SomeZeldaFan/RocketPi-5/docs/01-constraints.md

# Project Constraints & Context

**Version:** v1.1 (locked — supersedes v1.0)
**Last updated:** 2026-05-21
**Status:** Phase 0 complete. Phase 1 complete — architecture locked (D024–D034), hardware selected (D038–D042), coding framework complete (D043). Validation protocol locked (D045, §10.7).

---

## 1. Mission Need

Design, build, and validate a bench-top model rocketry GNC (Guidance, Navigation, and Control) suite demonstrating closed-loop attitude control with fault-tolerant sensor fusion under deliberate sensor compromise — using a Raspberry Pi 5 as the development and ground station platform.

This is a *founding statement*, not a specification. Specifications are downstream.

---

## 2. Intended Audiences

- **Aerospace engineering faculty** — the primary technical audience. The project engages real aerospace subdisciplines (GNC, FDIR) and must hold up to domain scrutiny.
- **Current program professor** — issued the Pi 5 kit; expects a completed deliverable. Scope and documentation must be legible to a software engineering background.
- **UAE aerospace and defense industry** — secondary audience for whom fault-tolerant GNC and GPS-denied operation analogues are directly relevant.
- **The builder** — technical growth and genuine understanding are first-class outcomes, not side effects.

---

## 3. Resources

### 3.1 Hardware on hand

Raspberry Pi 5 kit: Pi 5, breadboard, LCD display, starter kit components, power supply, SD card, case.

### 3.2 Tools available

- Soldering iron (trivial to acquire).
- Multimeter (trivial to acquire).
- 3D printer (accessible via family).
- Development computer: Ryzen 7 9700X, RTX 4080 Super, 64 GB DDR5. Firmware development, post-test analysis, and ML workloads are first-class options.

### 3.3 Acquirable

Additional sensors, microcontrollers, flight controllers, RF modules, mounting structures, 3D-printed parts, etc., all in scope subject to budget.

### 3.4 Budget

Soft ceiling **~$2,000 USD** across the project lifetime (excluding tools listed in 3.2). Not a hard cap; specific expenditures justified case-by-case.

---

## 4. Project Shape

**Bench-only model rocketry GNC suite, avionics- and systems-centric.**

The system is built to operational completeness on a test stand — IMU, sensor fusion, state estimation, control law, servo-driven aerodynamic control surfaces, ground station — but is **not flown**. Flight is excluded for procurement, regulatory, and logistical reasons (see §5).

The airframe is a custom-designed, 3D-printed semi-monocoque structure — a parallel structural engineering chapter of the project, not packaging. No resin, fibreglass, chemical coatings, or fibrous reinforcement of any kind. Structural reinforcement strategy (including possible metal linkages) is open. (D031, retires D011; D044 opens reinforcement boundary.)

The Pi 5 is bounded to: telemetry reception, frame logging, dashboard UI, and C2 command transmission. It is not in the real-time control path. (D032.)

A dedicated STM32F407ZGT6 MCU owns the entire real-time path: sensor read, sensor fusion, FDIR, control law, actuator command, mode FSM, and time authority. (D039, D025.)

---

## 5. Depth Axis: Fault-Tolerant Graceful Degradation

Beyond nominal closed-loop control, the system demonstrates **robust operation under deliberate sensor compromise.**

Failure modes characterized in scope:

- Magnetometer disturbance (nearby metal, magnetic interference)
- IMU sensor degradation or loss
- Sensor disagreement (innovation gating)
- Sensor disconnection

The system detects sensor inconsistency, isolates the faulty channel, and continues operating with degraded but bounded accuracy. This is the project's *distinctive depth axis* and what separates it from "student built a control system."

Robustness is **architected from day one**, not retrofitted (see §10).

This direction is selected because:

- It is honest to the bench setup (sensor robustness exists for stationary and moving vehicles alike).
- It maps to a real aerospace subdiscipline (FDIR — Fault Detection, Isolation, and Recovery).
- It is genuinely defense-relevant (jamming, spoofing, adversarial sensor environments).
- It does not force a project-identity reframe.

---

## 6. Demos (Deliverables)

### Demo 1 — Live bench demo (PRIMARY)

Live demonstration of control surfaces responding to physical perturbation of the test stand. Includes nominal operation and live demonstration of fault tolerance: disconnect a sensor mid-operation, watch the estimator degrade gracefully and report sensor health.

---

## 7. Scope: Inclusions

- IMU-based attitude estimation (sensor fusion, state estimator)
- Closed-loop control law driving servo-actuated aerodynamic control surfaces
- Sensor health monitoring and fault detection logic
- Graceful degradation under sensor compromise
- Bidirectional telemetry link between MCU and Pi 5 ground station. Downlink: sensor data, estimator state, sensor health. Uplink: mode commands from ground station to MCU.
- **Demo/flight mode toggle** — ground station can command the MCU between flight mode (real deflection limits) and demo mode (relaxed deflection limits for presentation legibility). MCU acknowledges all mode commands; ground station reflects active mode and acknowledgment status.
- **Live ground station UI** running on the Pi 5 (1024×600 touch display, or external monitor). Multi-pane dashboard showing: live telemetry charts, sensor health status and confidence indicators, the system's own estimate of data accuracy and veracity, a real-time 3D attitude visualization of the rocket body driven by the estimator output, and a separate zoomed view of the fin assembly showing actuated control surface deflections as they occur.
- Post-test analysis tooling (Python, on dev machine)
- Documentation: requirements, architecture, decisions, test results, post-project writeup

## 8. Scope: Exclusions

- **No flight.** Static / bench testing only.
- **No propulsion work.** Commercial motors only (and only as static prop, not fired).
- **No TVC (thrust vectoring control)** on any flight-intended article.
- **No projectiles, no kinetic payload, no weaponization** of any kind, in any framing.
- **No live motor firing.** Static fire tests are out of scope.
- **No multi-stage anything.** Single article, single configuration.
- **No GCAA permission-seeking** for this project. Closed; will not be revisited.
- **No swarm, no multi-vehicle.** Single article.
- **No autonomous mission planning.** This is a control system project, not an autonomy project.

---

## 9. Engineering Quality Rubric

Candidate scope additions and design decisions are evaluated against the following criteria. Re-read before any meaningful scope decision.

1. **Domain authenticity** — engages a real aerospace problem, not cosmetically. Fault-tolerant estimation is the project's primary authenticity claim.
2. **Technical depth** — at least one component requiring genuine learning beyond tutorial-level. The sensor fusion + fault detection pipeline carries this.
3. **Systems integration** — multiple subsystems with real interfaces. IMU, MCU, servos, telemetry radio, ground station — all must compose.
4. **Documentation & rigor** — written up as if for review. Requirements traced, decisions justified, results measured.
5. **Demonstrability** — non-builder can appreciate the result in under five minutes (Demo 1 satisfies this).
6. **Originality of choice, not invention** — the specific framing (bench-only, fault-tolerant, GNC-focused, defense-adjacent) is uncommon. Not novel research; genuinely uncommon at student level.
7. **Slog-to-learning ratio** — concepts and tasks should be net learning-dense. Mechanical tedium is acceptable when budgeted; uncharacterized tedium is a planning failure.

---

## 10. Locked Principles

### 10.1 Slog is estimated explicitly

Every concept and major task is evaluated for the ratio of learning-dense work to mechanical-tedium work. Slog phases are planned for, not encountered. We do not psych ourselves up about tedium; we put it in the schedule. (Adapted from how mature engineering organizations plan integration and test campaigns — slog is called schedule margin in industry.)

### 10.2 Architect for robustness from day one

Fault tolerance is not Phase 2. It shapes the architecture from the first commit. The first version of any estimator may be a trivial nominal implementation, but it exposes the *interfaces* fault tolerance needs: sensor health channels, innovation tracking, confidence bounds, graceful degradation paths. Retrofitting robustness is 2–3× the cost of designing for it. We will not pay that cost.

### 10.3 Decisions go in the log

Every architectural or scope decision is logged with date, decision, alternatives considered, and rationale. We do not relitigate decisions; we read the log.

### 10.4 Procurement reality is a hard constraint

The trade space is bounded by what can actually be acquired in the UAE within budget. Theoretical availability is not availability.

### 10.5 Authoritative sources for regulatory questions

When regulatory questions arise, the regulator (or its published rules) is the source of truth — not inference, not e-commerce restrictions, not forum posts. (Pattern established when contacting GCAA early in Phase 0.)

### 10.6 JPL Power of 10 coding standard

All control-path and flight-critical code abides by the NASA JPL Power of 10 rules. This is a non-negotiable quality floor, not a stretch goal.

### 10.7 Validation before implementation — tests are written before code

No code is flashed to hardware until it has passed its full dev-PC validation suite. No subsystem integration begins until per-peripheral bring-up tests pass. Tests are written before the module they test is implemented — a test written after the code confirms the code as written; a test written against the contract verifies the contract. Progression follows a non-bypassable gate structure (see `docs/07-test-plan.md`); a test that has not been run counts as a failing test. (D045.)

---

## 11. Open Questions

1. **True C2 depth (stretch).** Full command and control implementation — command authentication, sequencing, and link-loss fail-safe behavior on the MCU — is a stretch goal. Scope if time permits after core control loop is validated.

---

## 12. Version History

- **v0.1** (2026-05-11): Initial strawman. No domain locked.
- **v0.2** (2026-05-11): Domain locked (model rocketry). Project shape locked (bench-only, GNC-focused, avionics-centric). Depth axis locked (fault-tolerant graceful degradation). Flight excluded. Demos redefined. Scope inclusions and exclusions enumerated. Locked principles enumerated. Open questions surfaced.
- **v0.3** (2026-05-12): Public-facing reframe — mission statement depersonalized, stakeholder framing neutralized (§2 renamed to Intended Audiences), §9 renamed to Engineering Quality Rubric, JPL Power of 10 added as §10.6.
- **v0.4** (2026-05-12): Scope update — SD card onboard logging removed (Pi 5 handles all logging over telemetry); ground station UI description expanded to reflect multi-pane dashboard with 3D attitude visualization and fin deflection view.
- **v0.5** (2026-05-12): Open questions reframed as timeless (removed phase-gate language); NASA-STD-7009 added as a deferred candidate for simulation validation.
- **v0.6** (2026-05-12): Telemetry link made bidirectional; demo/flight mode toggle added to scope (D020); true C2 depth added as stretch open question.
- **v0.7** (2026-05-12): Time constraints removed from all sections; D002 retired via D021.
- **v0.8** (2026-05-15): Phase 1 top-level architecture review locked (D024–D034). Custom semi-monocoque 3D-printed airframe path adopted (D031); D011 retired. §8 airframe exclusion removed. §11.4 airframe-presence open question resolved. §11.1 (MCU choice) and §11.2 (IMU/baro selection) annotated with bounded trade spaces from the architecture decisions; open-question numbering shifted accordingly.
- **v0.9** (2026-05-19): Document prose cleaned up. Renumbered §3 subsections and remaining open questions.
- **v1.0** (2026-05-21): §4 updated to reflect Phase 1 locked decisions — custom semi-monocoque airframe (D031), Pi 5 role (D032), MCU selection (D039). D044 opens airframe reinforcement boundary.
- **v1.1** (2026-05-21): §10.7 added — validation-before-implementation locked principle (D045).
