SomeZeldaFan/RocketPi-5/docs/02-current-state.md

# Current State

**Last updated:** 2026-06-17

Live project status. Updated at the end of every work session.

---

## Where we are

**Phase:** Phase 1 — requirements first pass complete (D035–D036 logged). Hardware selection complete (D038–D042). Coding framework scaffold complete (D043, 2026-05-20): software architecture §4 locked, avionics directory layered scaffold created, all module headers + stub `.c` files in place. Test plan fully populated (2026-05-21): `docs/07-test-plan.md` carries the complete test enumeration and the G0–G4 gate structure; validation-before-implementation locked as a principle (D045, §10.7). **`platform.h` scrutiny complete (2026-06-17)** — the first per-module header scrutiny session: D048 (NVIC priority scheme) and D053 (watchdog architecture) logged, `platform.h` contract locked, foundation header `inc/fault.h` added. Active tracks: per-module header scrutiny continues (sensor-driver headers next), airframe structural design (CAD), literature reviews LR-2/LR-3 (unblocked by hardware selection; LR-1 complete per D052). Servos deferred pending CAD. **Host build+test loop established (2026-06-17)** — the algorithm layer + test harnesses compile and run natively on macOS/Apple Silicon via `avionics/Makefile`; all software development and testing now happens on the Mac (dev-PC dependency removed).

**Constraints doc:** v1.1 locked.
**Domain:** Locked — bench-only model rocketry GNC suite.
**Depth axis:** Locked — fault-tolerant graceful degradation under sensor compromise.
**Flight:** Excluded.
**System architecture:** Locked (D024–D034). Custom semi-monocoque airframe path adopted (D031); D011 retired.
**Software architecture:** Locked (D043). Bare-metal superloop with DMA + ISRs. Layered scaffold (hardware / algorithm / output / orchestration) in `avionics/` — see `docs/05-architecture.md §4`.

Pi 5 bring-up complete (DietPi v10.3.3, kernel 6.18.29, SSH access confirmed, GPIO stack verified). VS Code Remote-SSH setup deferred. Avionics component selection complete (D038–D042). Coding framework scaffold complete (2026-05-20) — MCU is STM32F407ZGT6; toolchain is STM32CubeIDE + HAL.

---

## What's done

- Phase 0 complete — project shape, depth axis, scope, and principles all locked.
- Constraints document locked at v1.1 (v1.0: §4 updated for Phase 1 decisions; v1.1: §10.7 validation-before-implementation principle added).
- Decisions log populated: D001–D052 (D048 reserved — NVIC priority scheme, to be logged in the `platform.h` scrutiny session; D050 logged 2026-06-14 — FDIR/estimator boundary).
- Coding standard locked: NASA JPL Power of 10.
- **Test plan fully populated (2026-05-21)** — `docs/07-test-plan.md` carries the complete test enumeration (build artifact, platform, all five sensor/peripheral bring-ups, FDIR/estimator/control-law/telemetry/C2/FSM unit tests, code coverage, boundary cases, exhaustive FSM coverage, power, bus contention, per-peripheral and concurrent fault injection, pipeline integrity, fault propagation, reboot recovery, timing margin, watchdog recovery, soak) and the non-bypassable G0–G4 gate structure. Tests are written before the modules they test (D045).
- **D044–D049 logged.** D044: airframe reinforcement boundary revised. D045: test protocol and gate structure. D046: actuator fault detection — operator-asserted (no servo feedback path). D047: loop overrun policy — warn, halt on 3 consecutive. D049: FSM responds to sensing health only, not actuator health.
- Ground station scope defined: multi-pane dashboard, 3D attitude visualization, fin deflection view, bidirectional C2 link, demo/flight mode toggle.
- **Phase 1 architecture review complete** (per D023). Eleven structural decisions logged as D024–D034, covering: IMU configuration, real-time path ownership, sensor bus topology, barometer inclusion, telemetry radio termination, MCU↔Pi physical link, control surface count, test stand / airframe configuration, Pi 5 role precision, power architecture, and authoritative time source.
- **Hardware selection complete** (D038–D042). UAE 433 MHz band confirmed (TDRA). MCU: STM32F407ZGT6 core board. IMU-1: GY-BMI160 (Bosch BMI160). IMU-2: ICM-42688-P breakout (TDK InvenSense). Barometer: MS5611 via GY-63 module. Radio: HolyBro SiK V3 433 MHz pair. All components on breakout modules or core boards — no custom PCB required. ST-Link V2 and full tooling procured. LR-2, LR-3, and coding framework all unblocked.
- Architecture document populated with hardware architecture (§2) and airframe structural architecture (§3 skeleton).
- Risk register, test plan, and bibliography expanded with airframe-side entries.
- **Pi 5 bring-up complete.** DietPi v10.3.3 installed on kernel 6.18.29+rpt-rpi-2712. SSH access confirmed at 192.168.3.25 (wlan0). GPIO stack verified: lgpio 0.2.2 + gpiozero 2.0.1 on gpiochip0 (RP1). Hardware revision e04171.
- **Requirements document first pass complete** (docs/04-requirements.md). Sections 1–8 populated: system-level, estimation, control, FDIR, telemetry, ground station, power, documentation. Sections 9–10 (airframe, demonstration) deferred as stubs. Eight performance requirements carry [TBD] placeholders pending literature review (LR-1 through LR-3) — see in-progress below.
- **D043 logged (2026-05-20)** — scheduling model: bare-metal superloop with DMA + ISRs. FreeRTOS explicitly rejected. Five-reason rationale documented; alternatives considered.
- **Software architecture §4 written and locked (2026-05-20)** — `docs/05-architecture.md §4`. Module decomposition, scheduling model with 12-step tick sequence, ISR table with volatile discipline, canonical type definitions, fault propagation chain with four invariants, module interface contracts, test harness strategy. GCS architecture explicitly deferred to its own session.
- **Avionics scaffold complete (2026-05-20)** — layered directory structure (`hardware/`, `algorithm/`, `output/`, `orchestration/`). `avionics_types.h` (canonical types, `volatile_flag_t`, `AVIONICS_PROTOCOL_VERSION`), `isr_flags.h` (manifest of all ISR/main-loop boundary crossings), 12 module headers with real declarations + comment contracts, 12 stub `.c` files with PLACEHOLDER RETURN comments and zero functional code, `main.c` superloop skeleton expressing the 12-step tick sequence, `stm32f4xx_it.c` and `stm32f4xx_hal_msp.c` HAL stub files, 4 dev-PC test harness stubs.
- **LR-1 complete (2026-05-22, D052)** — `AVIONICS_LOOP_RATE_HZ` = 1000 Hz locked; `IMU_STALENESS_THRESHOLD_US` = 5000 μs. Derived from 10 Hz disturbance bandwidth × 5× margin × Franklin Eq. (11.3) sampling rule. REQ-SYS-011, REQ-EST-002, REQ-CTL-008 resolved. LR-3 unblocked. Full write-up: `docs/derivations/LR-1-loop-rate.md`.
- **FDIR/estimator boundary resolved (2026-06-14, D050)** — two-phase estimator (`estimator_predict`/`estimator_update`) + two-phase FDIR (`fdir_admit`/`fdir_gate`), interleaved admit→predict→gate→update; new `predicted_readings_t` carries the estimator's predicted measurements to the gate as data (no estimator import). FDIR writes health in two passes (admit preliminary, gate restrict-only). Architecture §4.1/§4.2/§4.4/§4.5 updated and signatures locked. Unblocks the EKF and FDIR innovation-gate implementations and TEST-EST-011.
- **`platform.h` scrutiny complete (2026-06-17) — D048 + D053 logged.** First per-module header scrutiny session. **D048** (NVIC priority scheme): `NVIC_PRIORITYGROUP_4`, TIM2=0 / DMA-TC=1 / SysTick=15; boundary-variable consistency is structural (single word-aligned access + single-writer-per-variable), priority is latency/jitter only; the one main-loop RMW (flag-clear + page-index snapshot) is guarded by a `BASEPRI` critical section; the IMU double-buffer page index is now declared in `isr_flags.h`. **D053** (watchdog architecture): IWDG-only, prescaler /32 RLR 2937 (2.00/2.94/5.53 s band, fast corner anchored at 2.0 s), single-window boot with no per-`_init()` kicks, a boot-complete kick + tick-[13] kick loop, ordered RCC_CSR reset-cause readout (new `reset_cause_t` + `platform_reset_cause()`), accepted high-Z reset window with software safe-state, and a central `system_safe_halt()` (new foundation header `inc/fault.h`, defined in `orchestration/fault.c`) replacing the removed `platform_safe_state()`. `void` fail-fast init convention locked. TEST-PLT-005 and TEST-PLT-HW-007 unblocked; TEST-PLT-002 / PLT-HW-003/004/005 / WDG-001/002/003 updated. `platform.h` is implementation-ready.
- **Host build+test loop complete (2026-06-17).** `avionics/Makefile` builds the platform-independent algorithm layer (`estimator.c` / `fdir.c` / `control_law.c`) + the four test harnesses with Apple clang under the strict JPL flag set (`-std=c11 -Werror -pedantic -Wconversion -Wsign-conversion -Wcast-qual …`), running natively as arm64 on the MacBook Air M3; `make test` reports red/green. `avionics/test/test_support.c` supplies a host `system_safe_halt` (print + `abort()`) and an `assert_fail` location-capture; `inc/fault.h` gains a `-DHOST_TEST` ASSERT branch (D053-A7 amendment) that leaves the target ASSERT expansion provably unchanged. All software dev/test now runs on the Mac — no dev-PC dependency. The shared CHECK/report harness header is deferred to the first real test.
- **Magnetometer selected — D054 logged (2026-06-17).** Bosch **BMM150** on a **dedicated I2C bus** (alone on its own peripheral, not the MS5611 bus — preserves D026 isolation; a mag-bus hang cannot take the barometer). Yaw is now an observable, bounded EKF state; the constraints §5 magnetic-disturbance failure mode is now achievable. Canonical types gained `mag_status_t`, `mag_reading_t`, and `mag_healthy` in `health_flags_t`; `AVIONICS_PROTOCOL_VERSION` bumped 1 → 2 (wire-layout change). Header compiles clean under the strict host flags and all four host test executables still pass — no contract regression. No driver yet (hardware-layer mag driver is task 7). **R-YAW-01 closed.** Procurement caveat carried: the module must be a standalone BMM150, not a BMX160. Provisional `R` for the mag update awaits LR-2.
- **Estimator/FDIR contract made mag-ready — D060 + D061 logged (2026-06-18).** **D060** amends the D050-locked algorithm contract so the magnetometer flows through the pipeline: `predicted_readings_t` gains `mag_pred_ut[3]`; `fdir_gate_result_t` gains `chi2_mag` / `mag_gate_open` / `mag_stale_us`; `estimator_update`, `fdir_admit`, `fdir_gate` each gain a `const mag_reading_t *mag` param; architecture §4 + `main.c` call sites updated. The `.c` bodies stay stubs (real logic is Task 2 / Task 3). Honest framing recorded: the lone mag has no twin → no direct cross-check; it is gated analytically (innovation vs the IMU-predicted field) plus absolute invariants (`|B|` magnitude, dip angle) — which is what makes the §5 mag-disturbance mode detectable with one sensor. Host build clean + all four test exes pass (no contract regression). **D061** records the estimator state design for Task 2: true dual-IMU fusion via a 9-state error EKF with **per-IMU gyro bias** `[δθ, δb₁, δb₂]` (internal to `estimator.c`; no public-type change). This **unblocks Task 2 implementation.**
- **Estimator design locked + contract finalized — D062 logged (2026-06-18).** Full `estimator.c` design recorded so the coding session is pure algorithm: error-state MEKF (9-state), small-angle quaternion propagation, **sequential-scalar + Joseph-form** updates (accel₁/accel₂/mag + a **differential-bias pseudo-measurement** `H=[0|I|−I]`), single-precision numerical hygiene (renorm/symmetrize/PD-floor), Hamilton/NED conventions, accel+mag init, freeze-isolated-bias degraded modes, provisional `R`/`Q`/`P`/`g_nav`/`B_nav` with must-replace markers, JPL fixed-size purpose-built primitives, and **simple-robust-auditable-first** (compute is single-digit-% on the M4F — not the binding constraint). Two contract tweaks applied this session: **baro removed from `estimator_update`** (altitude unobservable in attitude-only state; FDIR still monitors baro), and **`attitude_estimate_t.covariance[6]→[9]`** (full EKF error diagonal) → **`AVIONICS_PROTOCOL_VERSION` 2→3** (GCS/telemetry must match). **Implementation method:** code landed section-by-section (≤50-line reviewed sections, deferred-commit-until-done).
- **TASK 2 COMPLETE — `estimator.c` implemented + validated (2026-06-19, D062).** The full 9-state error-state EKF is built and tested: nominal quaternion + per-IMU gyro bias; predict (gyro blend → small-angle propagation → `F·P·Fᵀ+Q` → predicted accel/mag for the gate); update (sequential-scalar Joseph corrections: accel₁/accel₂ → roll-pitch, mag → yaw, differential-bias → per-IMU separability); degraded modes via the NULL contract (IMU1/IMU2-only, dead-reckoning, freeze-isolated-bias); single-precision hygiene (renorm/symmetrize/PD-floor). JPL-clean: fixed-size, no malloc/recursion, bounded loops, single-precision `float`, ≥2 ASSERT/fn. **Validation:** `test_estimator.c` — 3045 checks across 12 scenarios, all green (static convergence; all three Euler signs incl. a DCM-independent analytic case; rotation tracking; degraded modes; covariance grows-on-loss/never-zero; reset/replay exact determinism; the **200× yaw-bounded-with-mag-vs-drifts-without** demo; per-IMU bias observability; noise robustness ~0.1°). `make coverage` (new target, shared `check.h` harness): **estimator.c 100% line, 100% function, 99.32% branch** (the one residual is the defensive PD-floor guard; assertion-failure arms excluded — death-tests deferred D053-A7). All provisional `R`/`Q`/`P`/`g_nav`/`B_nav` carry must-replace-before-ship markers (LR-2 / geomagnetic model). Critical path **1→2 done**; Task 3 (FDIR) is next.
- **TASK 3 COMPLETE — `fdir.c` implemented + validated; telemetry contract cleaned (2026-06-19, D063).** Two-pass FDIR built to the D050/D060 contract with a **two-tier severity model**: `fdir_admit` runs TIER-1 (hard) absolute checks (status, staleness, physical envelope/saturation, NaN/Inf, mag `|B|`) → **immediate latch**; `fdir_gate` runs TIER-2 (soft) innovation checks (per-channel chi² + the mag dip-angle) → **debounced latch** after `FDIR_DEGRADE_COUNT` consecutive failures. Per channel `health = (NOT latched) AND (no TIER-1 now) AND (gate open now)`; **latch clears only via `fdir_init()`** (reset = operator re-admit — no auto-recovery). The IMU1-vs-IMU2 gyro cross-check is a **detector only** (A1: never isolates on two-sensor disagreement; raises `gyro_disagree`). The gate normalises with **β innovation variances** exported by `estimator_predict` (`S_k = HₖP⁻Hₖᵀ+R` in `predicted_readings_t`) → adaptive, inversion-free `chi2 = Σ rₖ²/Sₖ` (no estimator import, single-precision FPU). Staleness "now" = newest input timestamp (no clock param / layer rule). JPL-clean: fixed-size static state (per-channel latch+counter), no malloc/recursion, bounded loops, ≥2 ASSERT/fn. **Telemetry-contract cleanup:** `fdir_gate_result_t` gains `gyro_disagree`; `telemetry_frame_t` gains `fdir_gate_result_t gate` + `reset_cause_t reset_cause` (D053 A4/A6) and `telemetry_pack_and_send`/`main.c` are threaded → **`AVIONICS_PROTOCOL_VERSION` bumped 3 → 4** (GCS parser + telemetry serializer must match). **Validation:** `test_fdir.c` — 83 checks across 21 functions (FDR-001…019 incl. reframed 011 + new 017/018/019, BND-001/002, the §5 mag-disturbance demo, severity/latch, restrict-only, gyro-detector, NULL-safety; TEST-FDR-014 grep confirms FDIR is the sole writer of `health_flags_t`). `make coverage` (extended to both modules): **`fdir.c` 100% line / function / branch**; `estimator.c` 99.36% branch after the β export. All provisional thresholds carry must-replace markers (LR-2 / LR-3 / CAL). Critical path **1→2→3 done**; Task 4 (control law) is next.

## What's in progress

- **Literature reviews LR-2 and LR-3.** LR-2: MEMS IMU estimation accuracy — run against BMI160 and ICM-42688-P datasheets (noise density, Allan deviation, bias instability); produces steady-state EKF error bound in degrees. Unblocked by D040. LR-3: FDIR innovation gating — chi-squared threshold and detection latency. Unblocked by D040 + LR-1 (D052, 1000 Hz).
- **Per-module header scrutiny sessions.** With the scaffold in place, each module header gets its own dedicated session to scrutinise the interface contract, type-check signatures against the fault propagation invariants, and lock the safe default returns currently marked as PLACEHOLDER. Headers do not move from scaffold to implementation-ready until they pass their scrutiny session. **`platform.h` done (2026-06-17, D048 + D053).** Next: the sensor-driver tier (`bmi160.h` / `icm42688p.h` → `ms5611.h` → `sik_radio.h`), then output (`actuators.h` / `telemetry.h` / `c2.h`), `mode_fsm.h`, `control_law.h`, and the algorithm layer (`fdir.h` / `estimator.h`) last.
- **Airframe: structural design — joint/segmentation/control-surface architecture LOCKED (2026-06-17, D055–D057).** The comprehensive head-to-tail airframe reference now exists: `docs/cad/airframe-architecture.md` (geometry, section-joint standard, datum hierarchy, stepped heat-set-insert depth solution, stringer strategy, avionics capsule, control surfaces, power/cabling, fabrication, open items). **D055** — segmentation + internal twin-flange joint (280 mm sections, OD174/bore150/12 mm wall, 8× M3 heat-set clamp ring, 4× inserted-aluminium stringer bridges with 1 mm relief, fastener-free skin; flange/stringer/bolt = axial/radial/clamp datums; no centring spigot). **D056** — control surfaces re-architected to 4 static aft fins + 4 actuated canards (canards are the sole control authority); supersedes D030's actuated-surface choice (fault-tolerance rationale preserved); requirements re-pointed (REQ-SYS-005, new REQ-SYS-013, REQ-CTL-002/003/004/005/006, REQ-FDR-001/007/009, REQ-PWR-004, REQ-GCS-005). **D057** — avionics-bay-as-detachable-capsule + dedicated 5 V servo rail (Rail B per D033). Section + joint geometry is printable now. **Remaining (CAD/open, airframe doc §12):** canard body station + pivot/linkage, static-fin attachment, nose-cone & service-panel retention (fastener-free), capsule fastening, cable mating, total length/section count, M3-vs-M4, insert model. Recommended next physical step: print a single-joint **test coupon** to validate insert depth, clamp, and skin denting before committing a full 280 mm section. **Revised same day (D058, D059):** aluminium stringers **removed** — the 8-bolt flange carries bench loads with several-times margin and a 162 mm/6 mm-wall tube is hugely over-stiff; skin wall thinned **12 → 6 mm** with bore 150 preserved (OD 174 → **162**), cutting wall volume well over half (R-AF-01 closed, R-AF-03 downgraded); the centring spigot is an **exploratory TODO**, not adopted. First article is a **minimal stack** (avionics / one empty section / aft-most / cosmetic motor mount), extend with empty sections later. D059: canards have **no aerodynamic authority** on the static bench — the demo is **commanded-response** with exaggerated demo-mode deflection for visual effect; REQ-CTL-001/006 reworded to govern the command path, not physical attitude restoration.
- **Pi 5 bring-up: VS Code Remote-SSH.** Final bring-up item — connect VS Code on dev laptop to Pi via Remote-SSH extension. Deferred from 2026-05-16 session.

### Literature review tasks — required before TBD requirements can be committed

These tasks must be completed before the indicated requirements in docs/04-requirements.md can have their numerical values set. Each produces a written summary and a justified number recommendation. **Sequencing matters — see dependency notes.**

- **LR-1 — Control loop rate** — **COMPLETE (2026-05-22, D052).** Result: 1000 Hz. See `docs/derivations/LR-1-loop-rate.md`.

- **LR-2 — MEMS IMU estimation accuracy** *(unblocks REQ-EST-006, REQ-CTL-007)*
  **Requires IMU selection first.** Runs on real datasheet noise specs (noise density, Allan deviation, bias instability) for the selected chips — not class-level estimates. Determine what steady-state attitude accuracy is achievable with the chosen dual-IMU EKF configuration. Produce a justified RMS error bound in degrees.

- **LR-3 — FDIR innovation gating design** *(unblocks REQ-FDR-008)*
  **Unblocked — LR-1 complete (D052, 1000 Hz) and IMUs selected (D040).** Chi-squared consistency test design for dual-IMU cross-check. Window size and threshold selection — uses the loop rate (1000 Hz) and IMU noise specs (datasheets) as inputs. Characterise the tradeoff between false-positive rate and detection latency. Produce a justified detection latency bound in milliseconds.

### Deferred — must be tracked, not lost

These items were explicitly deferred during the 2026-05-20 coding framework session. Each has a flagged comment in the relevant source file so the issue is not lost during downstream implementation.

- **Watchdog architecture scrutiny — RESOLVED (2026-06-17, D053).** IWDG-only (A1); /32 RLR 2937, 2.00–5.53 s band, fast corner anchored at 2.0 s (A2); single-window boot, no per-`_init()` kicks, boot-complete + tick-[13] kicks (A3); ordered reset-cause readout (A4); persistence needs no backup domain (A5); accepted high-Z window + software safe-state (A6); assert path via `system_safe_halt` (A7).

- **NVIC interrupt priority scheme (D048) — RESOLVED (2026-06-17).** TIM2=0 / DMA-TC=1 / SysTick=15, `PRIORITYGROUP_4`. Consistency is structural (single word-aligned access + single-writer-per-variable); priority allocates latency/jitter only; the one RMW exception (flag-clear) is guarded by a `BASEPRI` critical section, and the IMU page index is now in `isr_flags.h`. TEST-PLT-005 and TEST-PLT-HW-007 unblocked.

- **`CMD_FAULT_ACTUATOR` family (code dependency)** — `command_id_t` in `avionics/inc/avionics_types.h` needs a `CMD_FAULT_ACTUATOR` set/clear family, per actuator index, to support the operator-asserted actuator fault path (D046). Blocks TEST-C2-008, TEST-PFLT-005, TEST-INT-010, TEST-FPP-002, TEST-CFI-002, TEST-CFI-005. Must land before G2 closes.

- **`overrun_count` telemetry field (code dependency)** — `telemetry_frame_t` in `avionics/inc/avionics_types.h` needs an `overrun_count` field, present in every frame, to expose the D047 loop-overrun warning path in a release-build-safe way. Blocks TEST-TEL-008 and the frame-verified TEST-INT-004 warning path. Bundle with the D047 implementation work.

- **Build system — host portion DONE (2026-06-17).** The macOS/clang host build (`avionics/Makefile`) is live: the algorithm layer + test harnesses are validated to compile (zero warnings under the strict flag set) and run natively on the M3. This is what unblocked algorithm development. **Still deferred:** the STM32CubeIDE `.ioc` + `arm-none-eabi-gcc` target firmware build — needs CubeMX-generated HAL/startup/linker files and cannot run on the Mac; a separate later session.

- **`platform_safe_state()` layer violation — RESOLVED (2026-06-17, D053 A7).** Replaced by a central `system_safe_halt()` declared in the new foundation header `inc/fault.h` (includes nothing upward, callable from any layer, resolved at link time) and defined in `orchestration/fault.c`, where it drives `actuators_safe()`, disables interrupts, and spins → IWDG WATCHDOG reset. No function pointers (JPL Rule 9); single source of truth for the safe deflection. `platform_safe_state` stays absent from `platform.h`.

### New deferrals from the `platform.h` scrutiny session (2026-06-17)

- **Reset-cause-driven safe-boot policy (D053 A4/A6)** — `platform_reset_cause()` is implemented platform-side, but the *behaviour* it drives is deferred to FSM/telemetry/GCS scrutiny: a WATCHDOG/BROWNOUT cause → initial `SYS_MODE_SAFE_HOLD` + `actuators_safe()` at the boot-complete boundary, an operator-facing GCS message ("reset occurred → fins to safe state"), and an expedited (decimation-bypassing) first telemetry frame. Needs a **`reset_cause` field in `telemetry_frame_t`** and an **FSM boot-mode rule**. Confirmed intent — implement during the telemetry/FSM/c2 scrutiny sessions.

- **Hardfault post-mortem snapshot (D053 A5)** — optional debugging enhancement: snapshot CPU registers to backup SRAM in the hardfault handler so the next boot can inspect what faulted. Needs backup-SRAM enable in `platform_init` + a read-back path. Deferred; the essential "something faulted" signal already arrives as a WATCHDOG reset cause.

- **Project `ASSERT`-macro rollout / assertion-density audit (D053 A7 / C3)** — the `ASSERT` macro is defined now in `inc/fault.h` and used by `platform.c`, but the cross-module rollout and the JPL Rule 5 assertion-density audit (≥2/function, with the documented exemptions for `platform_timer_us` and `platform_watchdog_kick`) across every module is a separate follow-on.

- **`TICK_INT_PRIORITY` = lowest (D048 B5)** — SysTick must be set to the lowest preemption level (15) so it never perturbs the loop. `stm32f4xx_hal_conf.h` does not exist yet; the build-system session creates it and sets this; `platform_init` confirms.

- **64-bit monotonic uptime (D048/D053 C4)** — `platform_timer_us` exposes only the u32 wrap-safe primitive (rollover ≈ 71.58 min). The 24 h soak (TEST-SOK-002) crosses ~20 rollovers, so any *total-elapsed* accumulation needs 64-bit handling (delta-accumulation or a TIM2-overflow ISR). Built during soak instrumentation.

- **`_Static_assert(__NVIC_PRIO_BITS == 4)` + clock-tree `.ioc` config** — the `BASEPRI` shift assert and the PLL M/N/P/Q + APB-prescaler configuration land in the build-system/implementation session (`__NVIC_PRIO_BITS` comes from the not-yet-present CMSIS header). The C6 prescaler *derivation* is proven (D053 cross-ref); only the live config is deferred.

- **Yaw observability — RESOLVED (2026-06-17, D054).** Option (a) taken: a magnetometer (Bosch BMM150, dedicated I2C bus) was added, restoring an absolute yaw reference and reopening the §5 magnetic-disturbance failure mode (suits the depth axis). R-YAW-01 closed. Types + protocol-version scaffolding landed; driver deferred to task 7.

## What's blocked

Nothing blocked.

## Next concrete tasks

1. **Per-module header scrutiny sessions** — one session per header, deep review of contract, NULL semantics, safe defaults, and JPL compliance. **`platform.h` ✓ done (2026-06-17 — D048 + D053).** Remaining order: `bmi160.h` / `icm42688p.h` → `ms5611.h` → `sik_radio.h` → `actuators.h` (carry the `system_safe_halt`→`actuators_safe()` boot-stage-safe / no-op-pre-init requirement, D053 A7) → `telemetry.h` / `c2.h` (carry the `reset_cause` field + expedited-frame policy, D053 A4/A6) → `mode_fsm.h` (carry the fault-reset SAFE_HOLD boot-rule) → `control_law.h` → algorithm-layer last (`fdir.h` / `estimator.h`, boundary closed under D050).
2. **Build system session — host portion DONE (2026-06-17).** macOS/clang host build live (`avionics/Makefile`); algorithm layer + harnesses run natively on the M3, so all software dev/test happens on the Mac. Remaining (deferred): STM32CubeIDE `.ioc` for the STM32F407ZGT6 + `arm-none-eabi-gcc` target firmware build (CubeMX HAL/startup/linker).
3. **GCS session** — Python ground station decomposition deliberately deferred from the 2026-05-20 architecture session. Mirrors MCU decomposition: transport / protocol / parser / state model / dashboard / attitude viz / command sender / frame logger. Must implement runtime check of `protocol_version` field on every received frame.
4. **LR-2 — MEMS IMU estimation accuracy** — unblocked by D040. Run against BMI160 and ICM-42688-P datasheets. Produces steady-state EKF error bound in degrees (unblocks REQ-EST-006, REQ-CTL-007).
5. **LR-3 — FDIR innovation gating** — unblocked by D040 + LR-1 (D052, 1000 Hz). Produces detection latency bound and `CHI2_THRESHOLD_2DOF` value (unblocks REQ-FDR-008).
6. **Begin airframe CAD** — first-pass body geometry, avionics bay dimensioned to selected components, fin pivot locations. Run material coupon prints as structural design firms up.
7. **Pi 5: VS Code Remote-SSH setup** — install Remote-SSH extension in VS Code, configure ~/.ssh/config entry for the Pi, connect and verify Pi filesystem is accessible from the laptop.
8. **Compose the formal system block diagram** — referenced as deferred in `docs/05-architecture.md` §1. Choose diagramming methodology appropriate for the documentation standard.
9. **Servo finalisation** — after CAD provides torque and size requirements.
