SomeZeldaFan/RocketPi-5/docs/03-decisions-log.md

# Decisions Log

Append-only. Do not edit past entries. If a decision is later overturned, add a new entry referencing the prior decision and explaining why it's being changed. The point of this log is not to revisit decisions; it's to remember *why* they were made when something later seems to contradict them.

Format: **Date — Decision — Rationale — Alternatives considered.**

---

## 2026-05-11

### D001 — Adopt phased requirements-elicitation approach

**Decision:** Project follows Phase 0 (requirements scoping) → Phase 1 (detailed requirements + architecture) → Phase 2+ (build, test, integrate). No concept-locking until requirements and constraints are documented.
**Rationale:** Real engineering does not jump from mission need to solution. Premature concept lock is the dominant failure mode for ambitious student projects.
**Alternatives:** "Just pick a project and start" — rejected as the failure mode we're trying to avoid.

### D002 — Time budget set at ~400 hours (350–450 range) *(superseded by D021)*

**Decision:** Working assumption is ~20 hrs/week baseline + ~45 hrs/week × ~6 vacation weeks, with conservative haircuts for life and motivation troughs. Total budget ~400 hours across 16 weeks.
**Rationale:** Initial estimate of 128 hours was based on misread "3 hrs/week" — corrected after clarification that 20 hrs/week is sustainable.
**Alternatives:** Treating time as unbounded — rejected; unbounded budgets distort trade studies.

### D003 — Budget soft ceiling: $2,000 USD

**Decision:** Soft ceiling of $2,000 across project lifetime, excluding tools (soldering iron, multimeter, 3D printer access).
**Rationale:** Bounded budget forces honest trade-offs. Stipend supports this level comfortably.
**Alternatives:** Unbounded budget — rejected.

### D004 — Slog estimated explicitly during scoping

**Decision:** Every concept and major task is evaluated for the ratio of learning-dense work to mechanical-tedium work. Slog phases are budgeted, not encountered.
**Rationale:** Real engineering organizations plan integration and test time explicitly because the alternative is schedule lies. The failure mode "discover the project is 60% slog at week 10" is well-documented.
**Alternatives:** "Plan for the fun parts, react to the rest" — explicitly considered and rejected after discussion.

### D005 — Domain locked: model rocketry

**Decision:** Aerospace subdomain for this project is model rocketry, with framing TBD.
**Rationale:** Builder has demonstrated sustained pull (multiple full passes through BPS.space content prior to project initiation). Sustained motivation is the strongest predictor of completion across 400 hours.
**Alternatives:** Drones (pivot considered when procurement issues surfaced; rejected when bench-only rocketry path opened).

### D006 — Framing: avionics- and systems-centric, not airframe-centric

**Decision:** Project's focus is the avionics suite and control system. Airframe is a vehicle for the engineering, not the engineering itself.
**Rationale:** Plays to builder's software/systems strengths, pulls toward genuine aerospace (GNC), differentiates from typical hobbyist builds.
**Alternatives:** Airframe-centric build (more typical hobbyist framing) — rejected as less differentiated.

### D007 — Propulsion work excluded

**Decision:** No motor manufacture, no propellant work, no static fire tests, no propulsion engineering content. Any motors used (if any) are commercial.
**Rationale:** Propulsion safety ramp is multi-year. Inappropriate for project 1.
**Alternatives:** Commercial motor static fire — rejected for safety and complexity.

### D008 — TVC excluded from any flight-intended article

**Decision:** Thrust vectoring control is not part of the flight configuration. (Moot after no-flight decision.)
**Rationale:** Mechanical and control complexity beyond project 1 scope. BPS.space spent years refining TVC; we do not have that runway.
**Alternatives:** Aero surfaces (selected).

### D009 — Three-demo target defined

**Decision:** Initial demo set was (1) live bench control demo, (2) flight + telemetry video, (3) sim-vs-actual flight data comparison.
**Rationale:** Captures bench depth, flight validation, and engineering rigor.
**Subsequent revision:** See D012.

### D010 — Executive decision: no flight

**Decision:** This project does not fly anything.
**Rationale:** Procurement of mid-class motors restricted in UAE consumer channels; UAE wartime aviation posture adds regulatory friction; recovery and logistics in summer desert conditions impose further cost; institutional cooperation for launch logistics not available within timeline. Builder explicitly chose bench-only as the higher-confidence path.
**Alternatives:** Pursue institutional procurement channel and GCAA authorization for small motors — considered, rejected on time grounds.

### D011 — Custom airframe build excluded

**Decision:** No custom airframe design and fabrication. If an airframe is used, it is commercial.
**Rationale:** Custom airframe = aerodynamic stability analysis + structural design + fabrication. Three hard problems on top of an already-deep avionics project. Standard hobbyist practice is to modify commercial kits; this is the right path for project 1.
**Alternatives:** Build from scratch (3D printed or composite) — rejected on scope grounds.

### D012 — Demo 3 redefined

**Decision:** Without real flight data, "sim vs. actual comparison" is not deliverable. Demo 3 is redefined as: high-fidelity simulation of the vehicle in hypothetical flight, with the actual avionics software running against simulated sensor inputs (hardware-in-the-loop), and stress-test results.
**Rationale:** Honest about what is deliverable without flight. Simulation as a standalone deliverable is still rigorous and aerospace-authentic.
**Alternatives:** Drop Demo 3 entirely — rejected; simulation work is genuine engineering content.
**Superseded by D051 (2026-06-04).**

### D013 — Depth axis locked: Direction 1 (fault-tolerant graceful degradation)

**Decision:** Project's distinctive depth axis is graceful degradation under sensor compromise. Sensor health monitoring, fault detection, isolation, and continued operation under degraded sensors are core scope.
**Rationale:** Honest to bench setup (sensor robustness is not motion-dependent). Maps to real aerospace FDIR subdiscipline. Genuinely defense-relevant. Doesn't force project-identity reframe.
**Alternatives:**

- Direction 2 (visual odometry on Pi) — interesting but adds ~100–160 hours and a whole second estimation modality.
- Direction 3 (reframe as GNC tech demonstrator) — abandons rocketry identity.
- Direction 4 (no depth axis added) — defensible but lower ceiling.

### D014 — Architect for robustness from day one (principle)

**Decision:** Fault tolerance is not Phase 2 work. The architecture is designed for fault tolerance from the first commit, even if implementation is incremental.
**Rationale:** Retrofitting robustness costs 2–3× designing for it. "Stretch goal" features in solo projects reliably get cut. If we deferred fault tolerance, we would not ship it.
**Alternatives:** "Make it work, then make it robust" at project scope level — discussed and rejected. The principle applies at component scope, not project scope.

### D015 — GCAA permission-seeking out of scope

**Decision:** Email to GCAA will not be sent. The regulatory question is closed for this project because flight is closed.
**Rationale:** Builder's executive decision. Relationship-building rationale acknowledged but deprioritized.
**Alternatives:** Send a low-stakes relationship-building email — considered, declined.

### D016 — Defense framing permitted; weaponization excluded

**Decision:** Project may be framed for defense-aerospace relevance (sensor fusion, fault-tolerant GNC, GPS-denied operation analogs) without any kinetic, projectile, or payload-delivery elements.
**Rationale:** Defense framing helps with the HALCON/EDGE audience. Weaponization framing would be counterproductive (UAE wartime context, age, and student status make any weapon-adjacent work a serious mistake).
**Alternatives:** No defense framing — rejected as leaving real value on the table.

### D017 — Document architecture defined

**Decision:** Project maintains 9 documents: Constraints, Current State, Decisions Log (Tier 1, actively maintained); Requirements, Architecture, Risk Register (Tier 2, created in Phase 1); Test Plan, Lab Notebook, Bibliography (Tier 3, append-only as project progresses). All in plain Markdown in a git repo.
**Rationale:** Minimum viable document set that survives chat boundaries and provides project memory. Heavy enough to be useful, light enough to maintain.
**Alternatives:** Notion or Google Docs — rejected for git incompatibility. Lighter doc set — rejected for risk of context loss.

### D018 — Pi 5 OS: DietPi

**Decision:** Raspberry Pi 5 runs DietPi for bring-up and the project lifetime. Pi OS Lite retained as documented fallback if DietPi-specific issues surface (15-minute reflash).
**Rationale:** Lowest combined disk + cognitive overhead among Pi-5-supported distros. Debian-based, so the `apt` ecosystem and the Pi 5 GPIO stack (`lgpio`, `gpiozero`) are first-class — no compatibility cost for later Python scientific dependencies (NumPy, SciPy, RocketPy). First-boot `dietpi-software` TUI implements the "install only what I need" principle structurally rather than by post-hoc cleanup. Pi 5 officially supported since 2024.
**Alternatives:**

- Raspberry Pi OS Lite — rejected: larger footprint (~1 GB vs ~400 MB), runs default services we'd disable anyway. Retained as fallback.
- Raspberry Pi OS Full (Desktop) — rejected: desktop/browser/office overhead unjustified for a headless bench instrument.
- Ubuntu Server 24.04 LTS — rejected: Pi-5-specific peripheral support is second-tested vs Pi-OS-derived distros; gains nothing at this project's scale.
- Arch Linux ARM — rejected: rolling-release maintenance load across 16 weeks; Pi 5 kernel-patch support sometimes lags.
- Alpine Linux — rejected: musl libc breaks Python scientific wheels needed for simulation work later.
- Buildroot/Yocto — rejected: hours-to-days image build effort; not viable on this timeline.

---

## 2026-05-12

### D019 — Coding standard: NASA JPL Power of 10

**Decision:** All flight-critical and control-path code written for this project abides by the NASA JPL Power of 10 rules.
**Rationale:** Short (10 rules), principled, credible to aerospace reviewers, and actually enforceable by a solo developer without specialized tooling. Strikes the right balance between rigor and practicality for a student-level project that aims to read as professional aerospace engineering.
**Alternatives considered:**
- MISRA-C — more comprehensive (~140 rules) but requires static analysis tooling to enforce properly; overhead not justified at this scale.
- DO-178C — airborne software certification standard; overkill for a bench demo, not applicable without a certification authority.
- Custom disciplined subset — valid but less credible without a named standard to reference in documentation and writeup.

### D020 — Telemetry link made bidirectional: demo/flight mode toggle

**Decision:** The telemetry link between the MCU and Pi ground station is bidirectional. The Pi can command the MCU to switch between two operating modes:
- **Flight mode** — real deflection limits applied (±3° or equivalent per control law)
- **Demo mode** — relaxed deflection limits for presentation legibility

The MCU acknowledges mode commands. The ground station UI reflects the active mode and acknowledgment status.
**Rationale:** Turns the ground station into a genuine command and control node, not just a display. Strengthens defense-relevance framing. No new hardware required — LoRa modules are inherently bidirectional. The mode toggle is immediately legible to any audience. Scoped conservatively: basic acknowledgment only, not full C2 protocol.
**Alternatives considered:**
- Visual exaggeration only (ground station exaggerates fin movement on screen, hardware stays at real limits) — rejected as less honest and less interesting engineering.
- Full C2 implementation (authentication, command sequencing, link-loss fail-safe) — deferred to stretch goal; cost is 40–60 additional hours and adds real-time complexity to the MCU control loop.
- No C2 at all — rejected; bidirectional link is a meaningful scope addition with no hardware cost.

### D021 — Time budget tracking removed from documentation (supersedes D002)

**Decision:** Explicit time budgets, hour estimates, and week counts are no longer tracked in the project documentation. D002 is retired.
**Rationale:** Time constraints are an internal planning concern, not a property of the project or its engineering. Public-facing documentation should reflect what is being built and to what standard — not how long it takes.
**Alternatives considered:**
- Keep D002 and time tracking in constraints doc — rejected; it adds no value to external readers and frames the project as a student assignment rather than an engineering artifact.

### D022 — Repo structure: domain-first, aerospace-adjacent naming

**Decision:** Top-level repo structure is domain-first with aerospace-conventional naming. Six top-level directories: `avionics/` (MCU code: control loop, estimator, FDIR, telemetry), `gcs/` (Pi 5 ground control station: dashboard, C2, telemetry receiver), `sim/` (RocketPy + hardware-in-the-loop simulation), `analysis/` (post-test Python tooling), `hardware/` (KiCad schematics, STL files, wiring diagrams), `docs/` (engineering documents, formerly `Core/`). Each folder is an independent system with its own toolchain and build system.
**Rationale:** The folder layout reflects the system architecture directly — a reader opening the repo sees the system decomposition before reading a single line of code. Terms `avionics` and `gcs` locate the project in aerospace, not just embedded systems. Domain-first structure avoids the false unity implied by `src/` when the codebase spans C firmware, Python application, and Python simulation with no shared build system.
**Alternatives considered:**
- Organic/incremental (keep `Core/`, add folders as needed) — rejected; defers a decision cheaper to make now than after code exists.
- Traditional `src/` monorepo — rejected; `src/` flattens heterogeneous systems that don't share a build system or deployment target; reads as a software project, not an avionics project.
- Domain-first with generic naming (`firmware/`, `groundstation/`) — rejected in favor of aerospace-conventional terms.
- Keep `Core/` folder name — rejected in favor of `docs/`; standard name communicates faster to outside readers; the numbered file convention already signals deliberate structure without the folder name needing to carry that weight.

### D023 — Phase 1 opens with top-level system architecture review preceding requirements

**Decision:** Phase 1 begins with a structured options review of the top-level system architecture before requirements are written. The review identifies the major system nodes, interface choices, and structural decisions with genuine options and downstream consequences. The output is an explicit system concept that requirements and subsequent Phase 1 decisions sequence from.
**Rationale:** Requirements written without an explicit system concept are anchored to an implicit architecture scattered across the constraints doc and the engineer's working memory — not in a single authoritative artifact. Making the system concept explicit first ensures requirements are written against something concrete, and surfaces structural choices (IMU count, real-time path ownership, sensor bus topology) that directly constrain what requirements are achievable.
**Alternatives considered:**
- Write requirements first, derive system concept from them — rejected; requirements without a concrete system reference are either too abstract (no implementation path) or lock structural choices without examining them.
- Derive system concept informally from constraints doc prose — rejected; the constraints doc describes the system across multiple sections in prose; that is not an architecture artifact, it is a description.

---

## 2026-05-15

### D024 — IMU configuration: dual heterogeneous, separate buses

**Decision:** The avionics board carries two IMUs from different chip families (different manufacturers / different sensor families), each connected on its own physically isolated bus.
**Rationale:** Constraints §5 lists sensor disagreement (innovation gating) as an in-scope failure mode. A single IMU cannot demonstrate sensor disagreement at the hardware level — there is no second sensor to disagree with. Two IMUs are the minimum configuration that makes the depth axis demonstrable. Heterogeneous chips (different silicon, different firmware paths, different temperature behaviors) prevent common-mode failures from defeating the cross-check.
**Alternatives considered:**
- Single IMU — rejected; sensor disagreement detection becomes undemonstrable; only self-consistency checks (NaN, saturation, flatline) remain. The depth axis is partially gutted at the hardware level.
- Triple IMU with majority voting — rejected; 3× wiring, calibration, and bus consumption for marginal demo gain; voting is less aerospace-authentic at this project scale than innovation gating, which dual-IMU enables.

### D025 — Real-time path ownership: MCU-only

**Decision:** The MCU owns the entire real-time path: sensor read, sensor fusion, FDIR, control law, actuator command, mode FSM, and time authority. No code running under Linux (i.e., on the Pi 5) is ever in the control loop. This is stated as an explicit architectural rule, not merely an implementation preference.
**Rationale:** JPL Power of 10 (D019) cannot apply to Python on a general-purpose OS — half the rules are violated by the Python interpreter itself before user code runs. Any Pi participation in the real-time path would require either weakening the JPL claim or carving out an unprincipled exception. Linux scheduling jitter (kernel preemption, GC-style stalls, NTP adjustments) is incompatible with deterministic dt for the estimator. Clean architectural boundary: if the Pi crashes, the MCU continues operating and can detect loss of ground station heartbeat.
**Alternatives considered:**
- Hybrid with Pi running the estimator — rejected; round-trip through Linux into the control loop violates constraints §4 and makes JPL safety claim incoherent.
- Hybrid with Pi running slow offline FDIR diagnostics — deferred, not adopted; harmless but adds no Phase 1 demo value; can be layered on later without restructuring if a use case earns its keep.

### D026 — Sensor bus topology: SPI for IMUs, I2C for barometer alone

**Decision:** Each IMU connects to the MCU on its own SPI chip-select line on a shared SPI bus (point-to-point per device). The barometer connects on a dedicated I2C bus, alone on that bus.
**Rationale:** The dual-IMU decision (D024) only earns its keep if the bus topology actually isolates the two IMUs at the hardware level. I2C has a well-known hazard where one device can hang the bus (holding SDA or SCL low) and take all other devices on that bus with it — a single-fault common-mode failure that defeats fault isolation entirely. SPI's per-device chip-select gives hardware-enforced isolation: a misbehaving device with CS deasserted is electrically invisible to the bus, so one IMU's failure cannot reach the other IMU. The barometer is a slow, dissimilar sensor not in the IMU cross-check critical path; placing it alone on its own I2C bus means an I2C hang only loses the barometer, which is an acceptable single-channel loss. SPI also offers higher data rates that better suit the IMUs' desired sample rate.
**Alternatives considered:**
- Shared I2C bus for all sensors — rejected; one hung device takes all sensors down; defeats fault isolation; architecturally self-defeating for an FDIR project.
- Split I2C with IMU-1 on bus 1 and IMU-2 + baro on bus 2 — rejected; partial isolation only; IMU-2 and baro remain coupled.
- SPI for all sensors including baro — rejected; extra pin and driver for no isolation gain (baro is already alone on its bus in the chosen topology).
- I2C bus multiplexer — rejected; adds a part that itself can hang; complexity unjustified at this scale.

### D027 — Barometer included on MCU via I2C

**Decision:** A barometric pressure sensor is included on the avionics board, connected to the MCU via the dedicated I2C bus established in D026.
**Rationale:** Demo 3 (HIL simulation of hypothetical flight) requires an altitude channel; a flight simulation against avionics with no barometer driver is incomplete. The barometer is a dissimilar sensor type (pressure vs. inertial; membrane deflection vs. mass-on-spring) that supplies sensor diversity for FDIR — a common-mode failure that affects both IMUs cannot fool the barometer, strengthening the cross-check beyond what same-type redundancy alone supplies. Enables a clean bench demo of cross-modal sensor reasoning: a tap on the test stand makes both IMUs see acceleration, but the barometer sees no altitude change; the fused estimate correctly attributes this to horizontal perturbation rather than vertical motion.
**Alternatives considered:**
- Exclude entirely — rejected; Demo 3 becomes thin (no altitude channel in HIL); FDIR loses dissimilar-sensor diversity; bench demo loses the cross-modal narrative.
- Software-only barometer (simulated in HIL only, not on physical hardware) — rejected; breaks the "same firmware on real and simulated hardware" property that makes HIL credible.
**Note (D051):** HIL removed. Barometer retention is still justified on the remaining grounds — dissimilar-sensor FDIR diversity and the cross-modal bench demo narrative (tap the stand: IMUs see acceleration, baro sees no altitude change). Hardware decision unchanged.

### D028 — Telemetry radio direct to MCU via UART + DMA

**Decision:** The telemetry radio module connects directly to the MCU via a UART peripheral with DMA-driven ring buffer for both receive and transmit. The radio protocol stack (packetization, CRC, framing, command dispatch) lives in MCU firmware, JPL Power of 10 compliant. No dedicated communications coprocessor.
**Rationale:** At LoRa-class data rates (a few kilobits per second, a few hundred bytes per frame, ≤10 Hz cadence), the radio is not a CPU load problem; DMA reduces it to near-zero CPU overhead. JPL Power of 10 (D019) is specifically designed to make code like a radio driver coexist safely with flight-critical code on the same processor — bounded buffers, bounded loops, no dynamic memory, bounded ISRs. Adding a coprocessor admits we don't trust the standard to do its job; introduces a new node, new firmware, new interface, and a new failure mode (the coprocessor itself can fail, severing telemetry with the radio and MCU otherwise healthy).
**Alternatives considered:**
- Dedicated comms coprocessor — rejected; solves a problem that doesn't exist at our data rates; introduces a new failure mode; contradicts the JPL quality narrative.
- Terminate radio at Pi rather than MCU — rejected; puts Linux in the wireless C2 path, reintroducing scheduling jitter and breaking the determinism rationale.

### D029 — MCU↔Pi physical link: both radio and wired, same protocol

**Decision:** Both transports are present. The radio link is the primary operational link — used for live demos, satisfying the wireless C2 deliverable in D020. A wired USB-serial link is the dev/debug/backup channel — used for firmware flashing, log dumps, HIL data injection from the dev PC, and as a fallback if radio fails during a demo. Both transports carry the same protocol (same packet format, CRC, command structure); a transport abstraction layer in firmware and ground station software allows runtime switching without application-layer changes.
**Rationale:** Real avionics programs universally have a wired umbilical for development and a radio for operational use — you don't debug a flight computer over its telemetry radio. Radio-only would force all integration testing to wait on radio bring-up (a multi-front debugging trap) and leaves no demo fallback. Wired-only walks back D020's wireless C2 commitment. Same-protocol-on-both eliminates the two-codebases-to-maintain problem; the application layer is transport-agnostic.
**Alternatives considered:**
- Radio only — rejected; blocks all dev on radio bring-up; no HIL injection path; no demo fallback; not what real avionics programs do.
- Wired only — rejected; walks back D020 wireless C2 deliverable; loses defense-relevance framing.
- Both transports with different protocols — rejected; two command parsers, two ground-station modes, sync problems for no benefit.

### D030 — Control surfaces: four fins, independently actuated, "+" configuration

**Decision:** Four aerodynamic fins at 90° spacing in "+" configuration (fins aligned with principal axes), each independently actuated by its own servo on its own PWM channel.
**Rationale:** Symmetric to D024 on the actuator side. Three fins is the minimum count for 3-axis control; a single fin failure leaves only two fins, which cannot control three axes — single-fault unrecoverable. Four fins leave three after a single failure, which is the minimum for 3-axis control; a reconfigurable mixing matrix can redistribute control authority across the remaining three. This makes actuator fault tolerance demonstrable, and unlocks the compound-failure demo (simultaneous sensor and actuator faults, both isolated, system continues stabilizing) — the single most aerospace-authentic moment the project can produce. "+" configuration over "×" because pitch/yaw/roll mixing is simpler and more intuitive; the exact orientation is a downstream detail.
**Alternatives considered:**
- Three fins at 120° spacing — rejected; actuator fault tolerance is structurally undemonstrable; half the FDIR story missing.
- Four fins ganged in pairs (pitch pair, yaw pair) — rejected; pays the four-servo cost without earning fault-tolerance redistribution capability; loses on roll authority.
- "×" configuration — deferred; viable alternative orientation but "+" is the simpler default for a student-scale project.

### D031 — Custom semi-monocoque airframe as parallel structural engineering chapter; retires D011

**Decision:** The bench article is a custom-designed, 3D-printed semi-monocoque airframe — designed, structurally analyzed, fabricated, and tested as a parallel engineering deliverable to the avionics work. The airframe becomes a real chapter of the project, not a piece of packaging. This decision retires D011 (commercial-kit-only) and resolves the airframe-presence open question previously held at constraints §11.4. **Explicit scope boundary:** the structural reinforcement strategy is FDM-print-only — filament selection (among PETG / ABS / ASA / CF-filled variants), wall thickness, infill density and pattern, print orientation, and printed-in ribs/stringers. No fibrous post-print reinforcement, no resin layup, no epoxy work.
**Rationale:** D011's original rationale had three legs: (1) aerodynamic stability analysis, (2) structural design, (3) fabrication. Leg (1) is invalidated by D010 (no flight) — a bench-only article has no aerodynamic stability requirement. Leg (2) becomes tractable in a bench-only load envelope (perturbation forces in the tens of newtons, well within FDM-printed material capability). Leg (3) is accessible via the 3D printer available per constraints §3.2. Two of three legs are gone or substantially weakened; the third (engineering effort) becomes a deliberate scope choice that the lead engineer accepts. The custom airframe supplies aerospace authenticity at a structural layer that no modified hobbyist kit can match (commercial kit body tubes are not semi-monocoque structures), and gives Demo 3 mass properties derived directly from CAD rather than measured from an opaque kit. The builder's motivation for the structural work is a real engineering input — D005's reasoning applies (sustained pull is the strongest completion predictor).
**Alternatives considered:**
- Reaffirm D011 (modified commercial airframe) — rejected; the locked-decision rationale is materially weaker post-D010, and the structural-engineering opportunity is one the lead engineer wants to take.
- Purpose-built bare avionics test rig (no airframe) — rejected; constraints §9 calls domain authenticity non-negotiable; a bare rig reads as embedded systems with aerospace vocabulary, not as rocketry.
- Hybrid (rig for development, airframe for final demo) — rejected; two integrations create integration debt that always surfaces close to the demo deadline; the right pattern is to integrate in the target geometry from the start.
- 3D-printed packaging shell without genuine structural design — rejected; pays most of the cost of going custom without the rigor that justifies it.

### D032 — Pi 5 role: bounded to display, C2, logging

**Decision:** The Pi 5's role is explicitly bounded to: telemetry reception (over radio or wired transport), logging of all received frames to local storage, dashboard UI rendering, and C2 command transmission (operator inputs to the MCU). HIL simulation runtime hosts on the dev PC, not on the Pi. Post-test analysis hosts on the dev PC, not on the Pi.
**Rationale:** An explicit role boundary is needed to prevent implementation-time scope creep that drags estimation or FDIR-adjacent logic across the Linux boundary in violation of D025. Resource-honest sizing: the dev PC (Ryzen 7, 64 GB DDR5, RTX 4080 Super) is dramatically more capable than the Pi 5 for compute-intensive HIL simulation and analysis; cramming those workloads onto an SBC wastes available capacity for no benefit. Pi-side logging is consistent with constraints v0.4's earlier scope lock (MCU-side onboard logging removed).
**Alternatives considered:**
- Display + C2 only with no logging — rejected; contradicts constraints v0.4.
- Pi as HIL simulation host — rejected; wastes the dev PC; crams compute-heavy simulation onto resource-constrained SBC; ties simulation development to Pi's environment.
- Pi as offline analysis host — rejected; strictly worse than dev PC for analysis work, which is iteration-heavy.
**Note (D051):** HIL on dev PC cancelled. Dev PC role reduced to firmware development environment and post-test analysis host. Pi role unchanged.

### D033 — Power architecture: split rails, common ground

**Decision:** The avionics use two separate power rails sharing a common ground. Rail A (clean): regulated low-noise 3.3V / 5V supplying MCU, both IMUs, barometer, and radio module. Rail B (servo): 5–6V high-current supplying the four servos. Power-on sequencing brings Rail A up first, then Rail B (to avoid servo twitching before the MCU initializes commanded positions).
**Rationale:** Four servos in simultaneous hard slew (the worst case during perturbation response, made possible by D030's four-fin layout) draw 4–8 amps peak. On a shared rail, those current spikes cause voltage sag that can brown out the MCU and inject high-frequency noise into sensor ADC references. Both effects produce artifacts that look like sensor faults to FDIR — false positives correlated with servo activity, which is poisonous for a project whose depth axis is fault detection. Topology-level isolation eliminates the failure class structurally rather than relying on heroic decoupling that doesn't fully solve sustained-current sag.
**Alternatives considered:**
- Single shared rail — rejected; brownouts and noise contaminate FDIR.
- Two fully separate batteries — rejected; overkill at bench scale; doubles power infrastructure for marginal additional isolation over the split-rail topology.
- Single rail with aggressive decoupling — rejected; capacitors handle high-frequency noise but cannot supply sustained current at servo loads; partial fix that doesn't solve the actual problem.

### D034 — Authoritative time source: MCU hardware timer

**Decision:** The MCU's hardware monotonic timer (microsecond resolution, dedicated peripheral) is the authoritative source of time for the entire system. Every sensor reading is paired with an MCU timestamp at the moment of measurement; every telemetry frame carries an MCU timestamp in its header. The Pi inherits MCU time for all logging, replay, and analysis math. The Pi's own system clock is used only for human-readable session naming and as observational metadata for transport-layer diagnostics (e.g., diagnosing radio link latency). Pi time is never used for any math involving event ordering, intervals, or correlation.
**Rationale:** The estimator's fusion math depends on consistent monotonic dt between measurements; the FDIR cross-check between IMU-1 and IMU-2 depends on accurate per-reading timestamps to find time-aligned pairs. Pi-side timestamps would be contaminated by radio transmission variance and Linux scheduling jitter — milliseconds of randomness that corrupt dt and break cross-session comparison. Hardware-monotonic time is the discipline every real avionics system follows for these reasons. The MCU's view of time is continuous and immune to OS-level interruption; the Pi's view of MCU time is downstream and can be interrupted without corrupting the record.
**Alternatives considered:**
- Pi timestamps on receipt — rejected; radio + Linux variance contaminate timestamps; replay analysis becomes noisy; cross-session comparison breaks.
- Both clocks with Pi as authoritative — rejected; same problem as Pi-only.

---

## 2026-05-18

### D035 — User-implemented estimation algorithm required; proprietary on-chip fusion excluded

**Decision:** The attitude estimation algorithm shall be implemented in full by the project author. Proprietary vendor-provided on-chip fusion firmware — including fusion modes such as the BNO055's NDOF mode — is excluded. The algorithm source code must be fully inspectable and compliant with the NASA JPL Power of 10 standard. An EKF or equivalent user-implemented algorithm (e.g., Madgwick/Mahony complementary filter) satisfies this requirement.
**Rationale:** Three independent reasons, each sufficient alone. First, JPL Power of 10 (D019) cannot be applied to firmware that cannot be read — a vendor fusion blob is a black box, and claiming compliance for it is indefensible to an aerospace reviewer. Second, the project's educational rationale (D005) requires that the fusion algorithm is built and understood; delegating it to a chip vendor defeats the purpose. Third, the FDIR cross-check (D024) requires raw sensor residuals — on-chip fusion may silently correct a fault before the FDIR module sees it, hiding the fault rather than exposing it.
**Alternatives considered:**
- BNO055 in NDOF fusion mode — rejected; all three rationale legs apply.
- BNO055 in raw output mode (fusion disabled) — rejected; raw mode is not the BNO055's primary design configuration; the M0 co-processor still runs in the background; better to select chips designed as raw sensors.
- One fusion IMU + one raw IMU — rejected; asymmetric outputs make the innovation gate incoherent (different noise models, different uncertainty characteristics).
- Complementary filter (Madgwick/Mahony) instead of EKF — not rejected; this is covered by "or equivalent" and satisfies all three rationale legs. Decision on specific algorithm deferred to implementation.

### D037 — Hardware selection proceeds ahead of LR-2 and LR-3 completion

**Decision:** MCU, IMU, and barometer selection proceeds now, before LR-2 and LR-3 are complete. LR-2 (MEMS IMU estimation accuracy) is downstream of IMU selection — it requires real datasheet noise specs to produce a meaningful accuracy target, not a class-level estimate. LR-3 (innovation gating design) is downstream of both LR-1 and IMU selection, as IMU noise specs inform the gating threshold. The functional requirements already written (REQ-SYS-003, REQ-EST-008, D024, D026, constraints §11.1–11.2) are sufficient to bound the hardware trade space without LR-2 or LR-3 complete. LR-1 (control loop rate) is independent of hardware selection and runs in parallel.
**Rationale:** The direction of dependency between LR-2 and IMU selection runs from selection to LR, not the reverse. Running LR-2 before IMU selection would mean analysing against generic class-level sensor specs — producing an estimate rather than a committable requirement. Selecting IMUs on functional grounds first (SPI-capable, heterogeneous families, raw output per D035, UAE-procurable per constraints §10.4) and then running LR-2 against real datasheet specs produces a defensible, traceable requirement. Additionally, hardware procurement has lead times that compound with delay; and component dimensions (MCU, IMU packages) are needed to dimension the avionics bay in CAD.
**Alternatives considered:**
- Complete LR-2 before IMU selection — rejected; LR-2 against class-level specs produces an estimate, not a committable requirement. Direction of dependency is inverted.
- Complete LR-1 before MCU selection — not required; constraints §11.1 already bounds the MCU trade space to STM32F4-class and above; LR-1 is unlikely to produce a loop rate requirement that an F4-class MCU cannot meet; "and above" in the constraint is the explicit safety margin for this uncertainty.

### D036 — Demonstration requirements held open

**Decision:** The demonstration deliverables described in Constraints §6 (Demo 1, Demo 3) are held open and are not treated as locked prescriptive requirements. The specific demo format, scope, and acceptance criteria will be defined once the core system is functional and its actual capabilities are known. The §6 descriptions are illustrative of intent, not binding deliverables.
**Rationale:** Locking demo requirements before the system works risks designing the demo around a script rather than around the system's genuine capabilities. A demo defined after the system is working can be shaped to show what the system actually does well — which is more authentic and more compelling than one defined speculatively upfront. The core deliverable (a working fault-tolerant GNC system) is unchanged; the presentation of that deliverable is deferred.
**Alternatives considered:**
- Lock Demo 1 as a prescriptive requirement now — rejected; Demo 1 as described in §6 may not reflect the most effective way to present the system once it is working. The constraint on the demo should be the system's real capabilities, not an upfront script.
- Drop demos entirely — rejected; a live demonstration remains a project deliverable; only the prescriptive specification of its content is deferred.
**Note (D051):** Demo 3 cancelled. Single remaining demo is Demo 1 — live bench control with deliberate fault injection.

---

## 2026-05-19

### D038 — UAE frequency regulatory check: 433 MHz confirmed, radio band selected

**Decision:** TDRA frequency allocation confirms 433 MHz is available for use in the UAE. 433 MHz is the selected band. HolyBro SiK V3 433 MHz module ordered accordingly.
**Rationale:** Open question in constraints §5; blocker on radio selection per D028. With the regulatory finding confirmed against the TDRA frequency sheet, radio selection is unblocked and 433 MHz is the committed band.

### D039 — MCU selected: STM32F407ZGT6 core board

**Decision:** MCU is the STM32F407ZGT6 on a pre-assembled core board with 2.54 mm through-hole headers. H7 series evaluated and rejected in favour of F4.
**Rationale:** F407 meets all peripheral requirements: 3× SPI with DMA, 3× I2C, 6× UART with DMA, multiple PWM timer channels, 32-bit hardware monotonic timer (TIM2), FPU, 3.3 V I/O, 1 MB flash, 192 KB RAM. H7 series was rejected on one structural ground: the Cortex-M7 D-cache requires explicit cache clean/invalidate around every SPI DMA transaction — the failure mode lands directly on the highest-frequency code path (IMU reads). The F407 has no D-cache; DMA is deterministic. F407 is the proven platform for flight-controller-class applications (original Pixhawk, Betaflight F4); 168 MHz with FPU is sufficient for EKF, FDIR, control loop, and telemetry at required loop rates.
**Alternatives considered:**
- STM32H743ZI Nucleo — rejected; D-cache coherency on SPI DMA adds non-trivial complexity on the critical IMU read path; overkill for this project's math load.
- STM32H743ZI2 Nucleo — same rejection as H743ZI; additionally ~1,100 AED more expensive in UAE market with no substantive benefit.
- STM32H745ZI-Q / H755ZI-Q (dual-core H7) — rejected; inter-core complexity with no benefit for a single-threaded real-time application.

### D040 — IMU selection: GY-BMI160 (Bosch) + ICM-42688-P (TDK InvenSense)

**Decision:** Two heterogeneous IMU modules: (1) GY-BMI160 breakout (Bosch BMI160) and (2) ICM-42688-P breakout (TDK InvenSense ICM-42688-P). Each on its own dedicated SPI bus. Both modules have CS, MOSI, MISO, SCLK, and interrupt pins independently accessible.
**Rationale:** Satisfies D024 (dual heterogeneous IMUs), D026 (separate SPI buses), and D035 (raw output, no on-chip fusion). Bosch and TDK InvenSense are different silicon families — systematic failure modes are not shared, satisfying the fault-diversity requirement for FDIR. BMI160: 3200 Hz gyro ODR, 1600 Hz accel ODR, data-ready interrupt. ICM-42688-P: up to 32 kHz ODR, 0.0028 °/s/√Hz gyro noise density, data-ready interrupt. Both verified as breakout modules with all required pins accessible before selection.
**Alternatives considered:**
- BMI088 module (Bosch) — selected initially; became unavailable in UAE; replaced by BMI160 which meets all functional requirements.
- ICM-42688-P bare chip (LGA-14 package) — rejected; cannot be hand-soldered; breakout module required.
- Single IMU with redundant axis measurement — rejected; D024 locks dual heterogeneous; single silicon cannot satisfy fault-diversity requirement.

### D041 — Barometer selected: MS5611 via GY-63 module

**Decision:** Barometer is the MS5611-01BA03 on the GY-63 breakout module, I2C interface.
**Rationale:** Satisfies D027 (I2C barometer). MS5611 outputs absolute pressure and temperature via 24-bit ADC. Proven in rocketry and UAV applications. GY-63 exposes all required pins; PS pin pulled high by default (I2C mode). UAE-procurable.
**Alternatives considered:**
- BMP388 — capable; MS5611 selected on availability and established rocketry use.
- BMP280 — lower resolution; rejected in favour of MS5611.

### D042 — Radio selected: HolyBro SiK Telemetry Radio V3, 433 MHz

**Decision:** HolyBro SiK V3 pair, 433 MHz, 100 mW. Air module → MCU UART. Ground module → ground station Pi via USB. Operates as transparent serial bridge.
**Rationale:** Satisfies D028 (radio to MCU via UART+DMA), D029 (dual MCU↔Pi links), D020 (bidirectional telemetry). 433 MHz UAE-legal per D038. SiK transparent serial imposes no proprietary framing on the application layer. UART is DMA-compatible. Matched pair eliminates RF tuning and antenna matching work. 100 mW at 433 MHz is more than sufficient for bench demo range.
**Alternatives considered:**
- Bare LoRa module (SX1276) — more configurable but requires manual RF bring-up and antenna matching; SiK V3 is a proven matched pair with open firmware.

---

## 2026-05-20

### D043 — Scheduling model: bare-metal superloop with DMA + ISRs

**Decision:** MCU firmware uses a bare-metal superloop. A single main loop runs at a fixed rate enforced by TIM2 hardware timer. ISRs are minimal — DMA-complete ISRs set flags and swap double-buffer pointers; UART DMA ISRs advance ring buffer write pointers; TIM2 ISR sets the tick flag. All application logic runs in the main loop. FreeRTOS is explicitly rejected for this project.
**Rationale:** Five reasons, each independently sufficient.
1. JPL Power of 10 compliance (D019) is structurally satisfied — no heap, no threads, Rules 2 and 3 trivially met. With FreeRTOS, Rule 3 (no dynamic allocation) requires active enforcement rather than architectural inevitability.
2. Deterministic dt: TIM2 fires the loop tick; dt = 1/rate ± ISR latency (~hundreds of nanoseconds). The EKF prediction step depends on consistent dt. FreeRTOS scheduler jitter adds ~1–3 μs of timing uncertainty per context switch.
3. No new fault modes: FreeRTOS inter-task queues, semaphores, and mutexes are shared data structures that can block, overflow, or deadlock — new fault classes introduced for zero benefit in an FDIR-focused project.
4. Single thread of execution: fault reasoning is unambiguous. One call stack, one breakpoint. No priority inversion, no deadlock.
5. Math load is well within bare-metal headroom: EKF + FDIR + PID + telemetry at 1 kHz on F407 at 168 MHz with FPU runs in well under 500 μs per tick.
**Alternatives considered:**
- FreeRTOS preemptive tasks — rejected; see rationale above.
- FreeRTOS cooperative scheduling — rejected; worst of both worlds: all RTOS complexity, no preemption benefit, harder to detect loop overrun than bare-metal.
- Event-driven pure ISR chain — rejected; execution order non-deterministic; JPL compliance in ISRs is maximally constrained; worst-case execution time unanalyzable.

---

## 2026-05-21

### D044 — Airframe structural reinforcement boundary revised: chemical exclusions confirmed, mechanical reinforcements open

**Decision:** No resin, fibreglass, chemical coatings, or fibrous post-print reinforcement of any kind. Metal linkages (brackets, inserts, rods) for structural reinforcement are explicitly in scope and under consideration. D031's "FDM-print-only" boundary is amended on this point.
**Rationale:** D031 was written before detailed structural design began. As CAD work approaches, metal linkages are a practical and common technique for reinforcing 3D-printed structures at joint and load points — excluding them prematurely would constrain the structural design without engineering justification. Chemical reinforcements (resin, fibreglass, epoxy) remain excluded on complexity and process grounds.
**Alternatives considered:**
- Reaffirm D031's FDM-only scope — rejected; unnecessarily forecloses a standard fabrication technique before structural loads are characterized.

### D045 — Test protocol: full test plan before implementation, layered gate structure, tests before code

**Decision:** The project adopts a layered, gated validation protocol governing all implementation work.
- The complete test plan exists in `docs/07-test-plan.md` before any module is implemented. Every test carries an objective, setup, procedure, acceptance criteria defined in advance, apparatus, and an execution log.
- Tests are written before the module they test. A module does not enter implementation until its test entries exist.
- Progression is governed by a non-bypassable gate structure: G0 (build artifact validation) → G1 (dev-PC unit tests, boundary/edge coverage, exhaustive FSM coverage, ≥90% branch coverage) → G2 (per-peripheral hardware bring-up, power, bus contention, fault injection, calibration cross-reference) → G3 (full system integration, pipeline integrity, fault propagation, reboot recovery) → G4 (timing margin, watchdog recovery, soak, concurrent fault injection). A single failing test blocks its gate; a test that has not been run counts as failing.
**Rationale:** Tests written after code are written to pass the code as written; tests written before code are written to verify the contract. For a fault-tolerant GNC project presented to aerospace reviewers, the difference is detectable in the results. A gate structure makes "validated" a defensible, ordered claim rather than an assertion, and prevents implementation-time pressure from skipping verification. Codified into constraints §10.7.
**Alternatives considered:**
- Test after implementation — rejected; produces tests that confirm the code rather than the contract.
- Informal/ad-hoc testing without a gate structure — rejected; "validated" becomes unfalsifiable, and the order of bring-up (dev-PC before flash, peripheral before integration) is exactly the discipline that catches faults cheaply.

### D046 — Actuator fault detection mechanism

Standard hobby servos have no feedback wire to the MCU. The servo control loop is entirely internal. No return path exists. Decision: `actuator_healthy[i]` is operator-asserted via GCS command, not autonomously detected. Rationale: per-servo current sensing would require additional BOM hardware, ADC channels, and threshold calibration with uncertain reliability given variable servo current draw under different load conditions. The architectural value of degraded control modes is preserved — the control law correctly reconfigures when health flags are set. The limitation is in the detection trigger, not the response. Honest system claim: the system handles actuator faults correctly when informed of them. It cannot autonomously detect them.

### D047 — Loop overrun policy: warn on transient, halt on sustained

**Decision:** A single transient main-loop overrun does not halt the system. On a detected overrun (the tick flag is already set when the next tick begins) the MCU increments a consecutive-overrun counter and emits a warning in the telemetry frame via an `overrun_count` field. **3 consecutive** overruns trigger assert-halt and `actuators_safe()`. The consecutive counter resets to zero on any on-time tick.
**Rationale:** A one-off interrupt storm or thermal spike must not permanently halt a demo and force a power cycle. But ~3 ms of sustained real-time failure (at a 1 kHz loop rate) is the limit before the control loop is meaningfully broken — tolerance must be short because control is already degraded during any overrun. Three consecutive overruns is the balance: it rides through a single transient glitch and reacts fast to genuine sustained failure.
**Alternatives considered:**
- Halt on first overrun — rejected; too aggressive, transient-fragile, turns a recoverable glitch into a demo-ending event.
- Silently tolerate overruns — rejected; breaks the real-time guarantee with no signal to the operator.
- Windowed counter (N overruns within a sliding window) — rejected for now; consecutive counting is simpler to implement and analyse, and a genuine sustained fault trips it just as fast.

### D049 — Mode FSM responds to sensing health only, not actuator health

**Decision:** The mode FSM (`mode_fsm.c`) gates mode transitions on estimator/sensing health only — e.g. rejecting `SYS_MODE_FLIGHT` entry while the estimator is faulted. It has no dependency on `actuator_healthy[i]`. Actuator health is handled entirely by the control law's degradation chain (`CTL_MODE_FULL_AUTHORITY → 3FIN_REDUCED → 2FIN_REDUCED → SAFE_HOLD`).
**Rationale:** Clean separation of concerns — the FSM owns operator intent and sensing viability; the control law owns actuation viability. The control law's `SAFE_HOLD` is already the safety mechanism for total actuator loss, so an FSM gate on actuator health would be redundant. This keeps the FSM transition matrix bounded and reviewable: TEST-FSM-EXH-001's exhaustive matrix stays at 90 cells (3 modes × 6 inputs × 5 sensing-health states) with actuator-fault states deliberately and documentedly excluded.
**Alternatives considered:**
- FSM also gates FLIGHT/DEMO entry on actuator health — rejected; redundant with the control law's `SAFE_HOLD`, and expands the FSM transition matrix for no behavioural gain.

**Note on numbering:** D048 (NVIC interrupt priority scheme) was reserved here and **logged 2026-06-17** during the `platform.h` per-module scrutiny session (see that date's section). Its out-of-order number, logged at its real date, follows the same reserved-slot mechanism as D050. The D047→D049 gap is deliberate.

---

## 2026-06-04

### D051 — HIL simulation scrapped; scope reduced to three physical deliverables

**Decision:** Hardware-in-the-Loop (HIL) simulation is removed from the project scope entirely. Demo 3 (as described in constraints §6 and defined in D012) is cancelled. The `sim/` directory is retained as a structural placeholder per D022 but will not be populated. RocketPy is removed from the bibliography. The three remaining deliverables are: (1) physical 3D-printed airframe, (2) fault-tolerant GNC algorithm (estimator + FDIR + control law) running on the STM32F407, (3) ground station with live telemetry dashboard on the Pi 5.

**Rationale:**
1. HIL scope was never formally defined. Simulation requirements (docs/04, §10) and simulation architecture (docs/05, §6) remained deferred stubs at the point of this decision. Removing a component with no locked requirements, no locked architecture, and no code carries zero integration risk.
2. The project's core depth axis — fault-tolerant graceful degradation — is more compellingly demonstrated through live physical fault injection on the bench than through software simulation. A running system that survives deliberate sensor disconnect in real-time is a stronger proof-of-concept than an equivalent HIL run.
3. HIL validation (G1.5 gate, TEST-HIL-001 through TEST-HIL-008) was the only pre-hardware gate that proved closed-loop stability and FDIR detection under dynamic conditions. Removing it shifts that validation to the hardware phase. This is accepted: G1 unit tests cover algorithm correctness in isolation; the bench demo closes the loop physically. Any instability in degraded fin modes will surface during bench integration — which, given the bench-only scope of this project, is an acceptable trade.
4. The focused sprint model (mac-only pre-hardware work followed by a hardware phase) cannot absorb a parallel Python simulation workload without diluting the three physical deliverables. HIL would have required a closed-loop plant model (LR-4 dependency), a dev-PC Python harness, and a UART injection protocol — each a non-trivial effort with no bearing on the bench demo.
5. Funding has been secured. The project must ship a physical demo. Simulation is not a prerequisite for that outcome.

**Implications accepted:**
- Closed-loop stability in `CTL_MODE_3FIN_REDUCED` and `CTL_MODE_2FIN_REDUCED` is not proven analytically before hardware. Risk logged in risk register (R-HIL-01).
- FDIR fault detection latency (LR-3 bound) is validated only on physical hardware, not in a controlled synthetic scenario. Risk logged (R-HIL-02).
- TEST-EST-010 (deterministic replay) loses its original stated purpose ("required for HIL credibility"). It is retained as a standalone firmware quality gate — deterministic replay is a correctness property independent of HIL.
- LR-4 (plant model / vehicle dynamics for HIL closed-loop) loses its only consumer. LR-4 is cancelled.

**Alternatives considered:**
- Defer HIL indefinitely but keep it in scope — rejected; deferred scope that will never be executed is dead weight in every planning session. A clean removal is more honest.
- Retain HIL as optional stretch goal — rejected; optional scope in a sprint model creates ambiguity about what "done" means. The three deliverables are sufficient and unambiguous.
- Keep G1.5 gate as a software-only unit test gate without plant simulation — rejected; the gate as designed is specifically a closed-loop dynamic validation. Reusing the gate label for a different purpose introduces confusion. Affected tests are removed or repurposed individually.

---

## 2026-06-05

### D052 — Control loop rate: 1000 Hz

**Decision:** `AVIONICS_LOOP_RATE_HZ` = 1000 Hz. `IMU_STALENESS_THRESHOLD_US` = 5000 μs (5 × loop period).
**Rationale:** Derived in LR-1 (2026-05-22). Disturbance bandwidth ceiling fixed at 10 Hz; required control bandwidth set at 5× = 50 Hz (14 dB attenuation at disturbance frequency); Franklin §11.2 Eq. (11.3) sampling rule ωs/ωBW ≥ 20 gives fs ≥ 1000 Hz. ZOH delay verified at 5.6% of rise time (< 10% Franklin criterion). Log-spaced MOI sweep across full build-weight range (0.0587–0.0793 kg·m²) confirms recommendation is stable — MOI does not enter the bandwidth calculation in the absence of aerodynamic fin effectiveness (bench-only, no airflow). Full derivation: `docs/derivations/LR-1-loop-rate.md`. Resolves REQ-SYS-011, REQ-EST-002, REQ-CTL-008. Unblocks LR-3.
**Alternatives considered:**
- 500 Hz (10× disturbance, 3× BW margin) — rejected; insufficient disturbance rejection margin and misaligned with D047 rationale which already assumes 1 kHz.
- 2000 Hz (Franklin upper-range multiple 40×) — rejected; no control-quality benefit for a manual-perturbation bench system; increases compute risk unnecessarily.

**Note on numbering:** D050 is the FDIR/estimator boundary decision — logged below (2026-06-14), filling the slot that was held open for it. Its out-of-date-order number is the same reserved-slot mechanism that still holds D048 for the NVIC priority scheme (the D047→D049 gap).

---

## 2026-06-14

### D050 — FDIR/estimator boundary: two-phase estimator + two-phase FDIR

**Decision:** Resolve the FDIR/estimator boundary by splitting the estimator into `estimator_predict()` and `estimator_update()`, and FDIR into `fdir_admit()` and `fdir_gate()`, interleaved in the tick as `fdir_admit → estimator_predict → fdir_gate → estimator_update`. The estimator exports its predicted measurements as a new `predicted_readings_t` value, which orchestration passes into `fdir_gate()`; FDIR never imports the estimator. FDIR writes `health_flags_t` in two passes — `fdir_admit` sets the preliminary verdict; `fdir_gate` may only restrict it (set a channel unhealthy), never resurrect a channel admission isolated.
**Rationale:** The innovation gate must compare each sensor reading against the EKF's predicted measurement (residual = z − h(x_pred)). That prediction lives in the estimator, but the algorithm-layer isolation rule forbids FDIR from importing it (FDIR is the single writer of health; a cycle would muddy that authority). Splitting the estimator lets predict run first and export the prediction as data — the gate becomes computable with the dependency direction preserved. Splitting FDIR is required because `estimator_predict` is gyro-driven: the absolute checks that need no prediction (staleness, bounds, gyro-vs-gyro) must run in `fdir_admit` BEFORE predict consumes the gyro; otherwise a faulty gyro poisons the prediction and the post-predict gate wrongly condemns a healthy accelerometer — cross-channel fault propagation, which violates the isolation guarantee (D026; the property TEST-FDR-013 checks). The model-relative innovation gate runs in `fdir_gate` after predict, where the prediction exists.
**Alternatives considered:**
- Monolithic FDIR after predict (`predict → fdir → update`, single FDIR call) — rejected; predict consumes the gyro before any FDIR check, so a gyro fault corrupts the prediction and the gate then mis-flags the accelerometer (cross-channel fault propagation).
- Make `estimator_predict` internally robust to a bad gyro (clamp/reject inside the estimator) — rejected; puts health logic in the estimator, breaking the single-writer-of-health rule (architecture §4.4 invariant 1).
- Three-step resolution without a separate admit pass — rejected for the same gyro-poisoning gap; this is the version the scaffold first anticipated and is superseded here.
- Innovation-gate the barometer too (predicted altitude in `predicted_readings_t`) — deferred; baro stays correction-only this cycle and keeps its admit-pass staleness/bounds checks. Can be added later without changing the structure.
**Note:** This work surfaced that the selected IMUs (BMI160, ICM-42688-P) are 6-axis (no magnetometer), so yaw is unobservable and drifts on the gyro alone. Logged as R-YAW-01 in the risk register and as a deferred item in `02-current-state.md`; out of scope for this decision.

---

## 2026-06-17

*Logged during the `platform.h` per-module scrutiny session — the first header scrutiny session (per `02-current-state.md` "Next concrete tasks" #1). This session resolved two reserved sign-offs — the NVIC priority scheme (D048, held open since the D047→D049 gap) and the watchdog architecture (D053) — and locked the `platform.h` contract. Decisions were resolved interactively one at a time; the sub-point labels (A1–A7, B1–B6) are retained for traceability to the test plan. D048 keeps its reserved out-of-order number and is logged here at its real date, the same mechanism used for D050 (see the note under D052).*

### D048 — NVIC interrupt priority scheme

**Decision:** The Cortex-M4 NVIC is configured with priority grouping **`NVIC_PRIORITYGROUP_4`** (4 preemption-priority bits, 0 sub-priority bits — STM32F407 implements 4 priority bits = 16 levels), set explicitly in `platform_init()`. Interrupt assignments:

| ISR | Preemption priority |
|---|---|
| TIM2 update (loop tick) | 0 (highest) |
| SPI1 DMA-TC (IMU-1) | 1 |
| SPI2 DMA-TC (IMU-2) | 1 |
| I2C DMA-TC (barometer) | 1 |
| UART1 DMA-RX (radio) | 1 |
| SysTick (HAL) | 15 (lowest) |

The one main-loop read-modify-write that priority does **not** make safe — clearing an ISR-set `data_ready` flag while snapshotting its double-buffer page index — is protected by a `BASEPRI`-guarded critical section: `__set_BASEPRI(1u << (8u − __NVIC_PRIO_BITS))` (= `0x10`; masks priority ≥ 1, i.e. the DMA-TC level, while TIM2@0 keeps firing), snapshot the page index, clear the flag, `__set_BASEPRI(0u)`, then consume the buffer outside the critical section. A `_Static_assert(__NVIC_PRIO_BITS == 4)` pins the shift. The IMU double-buffer page index is therefore a genuine ISR↔main-loop boundary crossing and is declared in `isr_flags.h` (closing a gap where the manifest previously omitted it).

**Rationale:** Interrupt priority does **not** provide boundary-variable consistency — that comes from two structural properties: every flag and page-index is a single word-aligned access (no torn read/write), and every ISR is the sole writer of its own distinct variable (no two ISRs share a variable, so preemption cannot interleave two writers). Given those, priority allocates only **latency and jitter**, not atomicity. TIM2 is highest because it is the authoritative time source (D034): a delayed tick jitters the control-loop phase and corrupts the timestamp/`dt` that every sample and the estimator depend on. The four DMA-TC ISRs sit one level below and share a single level — each does <10 lines of flag-set/page-swap bookkeeping, the sample is already DMA-buffered, and the main loop consumes it only at tick boundaries, so sub-µs preemption is invisible. SysTick is forced lowest: HAL defaults it to 0 (highest), which would let it preempt TIM2 and the DMA-TCs, but it is HAL-only (init-time timeouts) and must never perturb the loop. The single RMW exception is real over time — the clear-flag race window, though tiny, lands across the ~86 M iterations of a 24 h soak — so the `BASEPRI` section closes it while keeping TIM2 alive (unlike `__disable_irq()`, which drops ticks).

**Alternatives considered:**
- DMA-TC ISRs highest (preempt TIM2) — rejected; minimizes sensor-flag latency at the cost of loop-tick jitter, but D034 makes tick timing the thing most worth protecting and the flag latency is harmless (data already buffered).
- Ranking the four DMA-TC ISRs — rejected; no flag-set ISR benefits from preempting another, and ranking adds nested-ISR latency and per-ordering justification.
- Sub-priority bits (e.g. `PRIORITYGROUP_2`) — rejected; sub-priority only tie-breaks simultaneously-pending same-preemption ISRs and never changes preemption — useless for a flag-set design.
- `__disable_irq()` around the flag-clear instead of `BASEPRI` — rejected; masks everything including TIM2, dropping ticks.
- Treating priority as the atomicity guarantee — rejected as incorrect; it would commit a false rationale to a permanent record. Atomicity is structural; priority is latency/jitter only.

**Documentation:** the scheme is reproduced verbatim in the `platform.c`/`platform.h` NVIC comment block and `docs/05-architecture.md §4`, with a prominent implementation-time caution that the `BASEPRI` shift, mask semantics, and "TIM2 stays live" property must be verified with extreme care and proven under TEST-PLT-HW-007 contention before the mechanism is trusted. **TEST-PLT-005 (static, G1) and TEST-PLT-HW-007 (dynamic, G2) are unblocked by this decision.**

### D053 — Watchdog architecture, boot/reset model, and the assert-path safe-state

**Decision:** Seven coupled sign-offs, resolved together (sub-points A1–A7):

- **A1 — Watchdog type.** IWDG is the sole watchdog; WWDG is not used.
- **A2 — Timeout.** IWDG prescaler `/32`, reload `RLR = 2937`. Because the STM32F407 LSI is specified 17 kHz (min) / 32 kHz (typ) / 47 kHz (max), a fixed reload yields a *band*, not a point: **2.00 s at the fast corner (47 kHz) / 2.94 s typ / 5.53 s at the slow corner (17 kHz)**. The fast (shortest) corner is anchored at 2.00 s because that edge governs false-trips. The clean-boot init sequence is budgeted to **1.0 s = 50 % of the fast-corner timeout** (verified by TEST-PLT-HW-005).
- **A3 — Kick placement.** No kicks during init. IWDG starts as the first action in `platform_init()` (covering a hung clock-tree bring-up); the entire ~12-module init runs inside one window; the first kick is a single **boot-complete kick** at the init→loop boundary in `main.c` — a known-good "all inits returned, entering loop" assertion that also resets the window — after which the main loop kicks every iteration at tick [13].
- **A4 — Reset-cause readout.** `platform_init()` reads RCC_CSR early and classifies via an ordered if-hierarchy — SOFTWARE → WATCHDOG (IWDG) → POWER_ON (POR) → BROWNOUT (BOR) → PIN (only reached if no specific flag matched) → UNKNOWN — then clears via RMVF. Exposed through a new `reset_cause_t` enum and `platform_reset_cause()` getter (growing the platform contract from three to four functions).
- **A5 — Persistence.** The cause needs no backup domain (held in RAM; hardware flags sticky until RMVF). The optional hardfault register-snapshot-to-backup-SRAM is deferred.
- **A6 — Safe-state on reset.** The high-Z fin window during the reset itself is explicitly accepted with no board-level mitigation. Safe-on-reset is the post-reboot software path: a fault cause drives an initial SAFE_HOLD + `actuators_safe()`, surfaced to the operator on the GCS and logged. (The SAFE_HOLD boot-rule, GCS message, and expedited frame are confirmed-intent, implemented during FSM/telemetry/GCS scrutiny.)
- **A7 — Assert-path safe-state.** `platform_safe_state()` stays removed from the hardware layer. The assert/halt-to-safe path is a central handler `void system_safe_halt(void)`, declared in a new foundation header `inc/fault.h` (includes nothing upward, so any layer may call it; resolved at link time) and defined in the orchestration layer (`orchestration/fault.c`), where it may include `output/actuators.h`, call `actuators_safe()`, disable interrupts, and spin. It does not reset; the independent IWDG then fires and surfaces the fault as a WATCHDOG reset (A4), so assertion failures and hardfaults funnel through the same path. The project `ASSERT` macro is concretely defined in `fault.h` this session (the cross-module density audit is deferred). Init functions are `void` and fail-fast (failure fires `ASSERT` → `system_safe_halt`); reaching the boot-complete kick therefore inherently proves all inits succeeded.

**Rationale:**
- A1: the threat is a hang (stuck bus, unresponsive sensor, hung clock-tree config). IWDG runs off the independent LSI and survives a hung clock tree; WWDG runs off PCLK1 and dies with the clock, missing the primary threat, and its max timeout (~tens of ms) cannot cover the init window. WWDG's windowed early-kick guards a runaway-fast loop we do not have (TIM2-paced; sustained overrun handled by D047).
- A2: a bench demo with an operator present has a loose hang-latency ceiling — a 5.53 s worst-case hang→reset is fine. What matters is a guaranteed floor (no boot loop) and a reasonable ceiling, not timeout accuracy, so an honest worst-case band on a fixed reload beats runtime LSI calibration (which would add a bounded calibration loop to `platform_init` for accuracy we do not need).
- A3: a kick at the init→loop boundary carries information (reaching it proves every `_init()` returned without hanging) and gives the first loop iteration a fresh window. Per-module kicks mask a hang occurring *after* a module's kick. The HSE-ready/PLL-lock spin-waits in `platform_init` are the real init-hang source and are bounded (JPL Rule 2), not `while(!RDY){}`.
- A4: knowing *why* the board rebooted — especially "was that a watchdog reset?" — is core to the fault-tolerance depth axis and required by TEST-WDG-003 / TEST-RBT-002. PINRSTF is set on nearly every reset (NRST is bidirectional, so internal resets pulse it), so it is trusted only when it is the sole flag — a property that falls out of checking specific causes first and returning on first match.
- A5: A4 already delivers the essential "something faulted" signal (hardfault → spin → IWDG → WATCHDOG); the snapshot only adds which instruction faulted — valuable but not load-bearing, and not a contract item.
- A6: STM32F4 GPIOs go high-Z at reset, so software cannot hold fins during a reset regardless; for a bench demo with no propulsion the brief uncommanded window is harmless, and a board-level backstop is unwarranted (servos are not yet selected). What matters is the post-reboot end state and operator visibility.
- A7: assertions fire from every layer, so the safe-halt handler is a cross-cutting concern belonging in orchestration (which legitimately sees both hardware and output layers). Declaring it in a foundation header and defining it at the top breaks the include-dependency without a function pointer (rejecting the callback on JPL Rule 9) and keeps a single source of truth for the safe deflection (rejecting a duplicated hardware-layer register write). Spinning rather than resetting funnels asserts and hardfaults through the same WATCHDOG path and keeps a SOFTWARE reset classified as a deliberate (clean) event.

**Alternatives considered:**
- WWDG instead of / in addition to IWDG (A1) — rejected; PCLK1-clocked, dies with the clock, cannot cover the init window.
- Runtime LSI calibration via the TIM5 capture route (A2) — rejected; adds init complexity for timeout accuracy a bench demo does not need.
- Per-module watchdog kicks (A3) — rejected; mask a hang occurring after a module's kick.
- Backup-SRAM hardfault post-mortem snapshot (A5) — deferred, not rejected; a debugging enhancement with no contract impact.
- Board-level fin-safe backstop during the reset window (A6) — rejected; the high-Z window is accepted and servos are unselected.
- `platform_safe_state()` as a hardware-layer register write (A7) — rejected; duplicates the safe-deflection definition across layers, risking divergence from `actuators.c`.
- A function-pointer callback for the safe-state handler (A7) — rejected; JPL Rule 9.
- `NVIC_SystemReset()` in `system_safe_halt` instead of spinning (A7) — rejected; would reclassify a SOFTWARE reset as a fault and split the assert/hardfault funnel.

**Cross-references:** the `platform.h` contract is locked to these decisions — watchdog-discipline block, `platform_reset_cause`, the `void` fail-fast init convention, the JPL Rule 5 assertion-density exemptions for the hot-path `platform_timer_us` and the single-register-write `platform_watchdog_kick`, the u32 wrap-safe timestamp idiom (`(now − then)`; rollover at 2³² µs ≈ 71.58 min is a known event, not a fault), and the TIM2 prescaler derivation (TIM2 on APB1 at 84 MHz, prescaler 83 → 1 MHz → count == µs; `datasheets/STM32F4xx.pdf` p.122). TEST-PLT-002, TEST-PLT-HW-003/004/005 and TEST-WDG-002/003 are updated to match (no per-init kicks; timeout band; reset-cause surfacing).

### D053-A7 amendment — host-test ASSERT branch (file/line/func capture)

**Decision:** The `ASSERT` macro in `inc/fault.h` gains a `-DHOST_TEST`-only branch. Under `HOST_TEST` a failed assertion routes to `assert_fail(__FILE__, __LINE__, __func__)` (declared in `fault.h`, defined in the host-only `avionics/test/test_support.c`), which prints the exact failing location to stderr then funnels into the same `system_safe_halt()` sink. The target build is unchanged: without `HOST_TEST`, `ASSERT` expands exactly as A7 locked it — the argument-free `system_safe_halt()`, no `__FILE__`/`__func__` literals, no signature change.

**Rationale:** The Mac is now the sole software dev/test environment, so exact host failure locations materially speed algorithm debugging. Capturing location in the macro (host-only, compile-gated) rather than in `system_safe_halt`'s signature keeps the cost off the target: no flash-resident `__FILE__` strings at every assert site (JPL Rule 5 → many sites), no added work in the one halt path that must never itself fail, and the locked `void system_safe_halt(void)` signature stands. On target there is no console at the halt point (spin → IWDG reset) and post-mortem location remains the deferred backup-SRAM snapshot work (A5).

**Alternatives considered:**
- Change `system_safe_halt` to take `(file, line, func)` — rejected; pushes host-only cost onto the locked target contract for information the target cannot consume until A5.
- `setjmp`/`longjmp` death-test harness (assert-fires-and-continue) — deferred; more machinery than the current need. `abort()` is the right minimal host behavior (SIGABRT → nonzero exit → `make test` FAIL).

**Cross-references:** host build system this session — `avionics/Makefile` (`-DHOST_TEST`), `avionics/test/test_support.c`. The `fault.h` contract comment describes both branches.

### D054 — Magnetometer selected: Bosch BMM150 on a dedicated I2C bus

**Decision:** The magnetometer is the Bosch Sensortec **BMM150** (3-axis geomagnetic sensor, I2C/SPI breakout), placed **alone on its own dedicated I2C bus** (a second I2C peripheral, not the MS5611 bus). Canonical types gain `mag_status_t` (mirrors `imu_status_t`), `mag_reading_t { float field_ut[3]; uint32_t timestamp_us; mag_status_t status; }`, and `mag_healthy` in `health_flags_t`; `AVIONICS_PROTOCOL_VERSION` bumps 1 → 2 (the new health field changes `telemetry_frame_t`'s wire layout). No driver yet — the hardware-layer mag driver is task 7. Resolves R-YAW-01; reconciles the constraints §5 magnetic-disturbance failure mode with the hardware.
**Rationale:** The selected IMUs (BMI160, ICM-42688-P) are 6-axis — gravity pins roll/pitch but nothing references heading, so yaw drifts unbounded on the gyro alone (R-YAW-01). A magnetometer restores an absolute yaw reference, making yaw an observable, bounded EKF state, and **reopens the magnetic-disturbance failure mode** that §5 lists but the prior hardware could not exhibit — directly serving the fault-tolerance depth axis. BMM150 chosen on: real Bosch datasheet (noise density, Allan/bias specs) feeding LR-2's justified `R` — no magic constants; full-scale ±1300 µT (x,y) / ±2500 µT (z) gives headroom so a near-field metal disturbance yields valid-but-wrong readings rather than a railed sensor (the demo needs the gate to catch bad data, not saturation); I2C address 0x10/0x13 — no collision with the MS5611 (0x76/0x77). **Dedicated I2C bus, not shared with the MS5611:** preserves D026's isolation property (one device per bus → an I2C hang loses only that channel), so a mag-bus hang cannot also take the barometer, and keeps the slow mag off the time-critical SPI/IMU path. Cost is ~2 GPIO + a second I2C init — cheap on the 144-pin F407ZGT6. Two caveats, logged as considered tradeoffs, not oversights: (1) BMM150 is Bosch, same family as IMU-1 (BMI160) — minor because the mag is non-redundant (no mag-vs-mag cross-check; it is innovation-gated against the estimator's *predicted* field, not another sensor), but a Bosch-family common-mode could degrade IMU-1 and the mag together; FDIR degrades gracefully (isolate both → IMU-2 + dead-reckoned yaw). (2) BMM150 raw output requires Bosch trim-register compensation to yield true µT — a task-7 driver cost vs LIS3MDL's straight sensitivity scale. **Confirmation note for procurement:** the module must be a *standalone* BMM150, **not a BMX160** (BMI160+BMM150 on one die), which would hard-couple the mag with IMU-1 and defeat the isolation rationale.
**Alternatives considered:**
- **LIS3MDL (ST)** — strong alternative: simpler driver (direct sensitivity scale, no trim compensation), dissimilar silicon from both IMUs, I2C+SPI, ±16 gauss. A genuine close call; BMM150 chosen on UAE procurability and full-scale headroom. Retained as the fallback if BMM150 sourcing or the standalone-vs-BMX160 check fails.
- **QMC5883L / GY-271** — cheapest and most ubiquitous, but thin datasheet (poisons LR-2's justified-numbers rule), I2C-only (would force the shared-bus coupling), and clone-quality variance. Rejected as primary; acceptable last-resort fallback only.
- **MMC5983MA (Memsic)** — best raw noise, but a set/reset coil adds driver complexity and it is more exotic to source. Rejected on pragmatism for the accuracy we need.

## 2026-06-17 (airframe)

### D055 — Airframe segmentation and section-to-section joint standard

**Decision:** The airframe is built as a stack of identical-cross-section printed cylindrical **sections** with a uniform internal joint standard. Section geometry: length **280 mm**, OD **174 mm**, bore **150 mm**, wall **12 mm**, internal flange radial width **15 mm** (flange opening Ø120). The outer skin is a **continuous, fastener-free surface** — every fastener is internal. Sections join via an **internal twin-flange bolted joint**: the lower section presents a **thick flange** (15 mm boss, heat-set brass inserts), the upper section a **thin flange** (screw clearance holes); **8 × M3 screws on a 67.5 mm pitch-radius ring carry all axial clamp load**, generated by the screw head bearing on the thin flange (never by bottoming). The thick-flange hole is a **stepped pilot** (Stage 1 = insert pilot Ø, depth = insert length; Stage 2 = smaller screw-clearance Ø) whose diameter-step shoulder is the insert's repeatable bottom datum and gives screw-tip clearance. **4 × CNC solid-aluminium stringers** (Ø5 bores at R81, at 12/3/6/9 o'clock; 200 mm rods) bridge each joint, seated 100 mm into each section with the upper socket bored to **101 mm** (1 mm axial relief) so the stringers carry **no clamp load**. The datum hierarchy is one feature per job: **flange faces = axial**, **stringers = radial + clocking alignment**, **bolts = clamp**. No central spigot/register. Full reference: `docs/cad/airframe-architecture.md`; parametric insert/clamp formulas in `docs/cad/aft-most-section.md`.
**Rationale:** The ~300 mm print build volume caps section length, forcing a segmented airframe. An internal joint preserves the continuous outer skin (presentation requirement). Splitting the joint's three jobs onto three features avoids over-constraint: a single feature for axial, one for radial/clocking, one for clamp, so two separately-printed sections actually assemble. The stepped insert pilot solves heat-set depth inconsistency (the shoulder is a hard depth datum) while keeping the screw from bottoming. Stringers are local to the joints (not full-length spars) to avoid machining ~1.8 m of aluminium and to keep mass down; mid-span bending is carried by the printed skin — a deliberate, documented stiffness trade. Metal stringers are in scope per D044.
**Alternatives considered:**
- External band couplers / external fasteners — rejected; breaks the continuous fastener-free skin.
- Printed-in full-length stringers (true semi-monocoque) — rejected here; print-orientation and mass penalties, and the joint needs a discrete metal bridge anyway.
- Full-length solid-aluminium spars — rejected; machining cost and mass for no bench-load benefit.
- Bonded/glued joints — rejected; not serviceable/reusable, and chemical bonding is out of scope (D031/D044).
- A central centring spigot/register on the flange — rejected as unnecessary; the four stringers already serve as the radial/clocking datum, so a spigot would re-introduce over-constraint.
**Cross-references:** D031, D044; `docs/cad/airframe-architecture.md`, `docs/cad/aft-most-section.md`, `hardware/cad/aft-most.step`. PLA creep under sustained clamp is an accepted, out-of-scope limitation for this bench-only sub-month article (airframe doc §10).

### D056 — Control surfaces: four static aft fins + four actuated canards (supersedes the actuated-surface choice in D030)

**Decision:** The airframe carries **eight aerodynamic surfaces in two sets**: (1) **four static aft fins** — fixed, non-actuated, 90° "+", at the aft section, carrying no PWM channel; (2) **four actuated canards** — forward, 90°, each driven by its own servo on its own dedicated PWM channel. **The canards are the entire control authority**: closed-loop attitude control, the runtime mixing matrix, flight/demo deflection limits, and the 3-of-4 actuator-fault reconfiguration all act on the canards. This **supersedes D030's choice of the aft fins as the actuated surfaces**; D030's fault-tolerance rationale (four independent actuated surfaces ⇒ survive a single actuator fault on the remaining three) is **preserved unchanged** and simply now applies to the canards.
**Rationale:** Separates stabilisation (passive aft fins) from control authority (active canards), which is a cleaner and more aerospace-authentic configuration than all-moving aft fins, and gives a visually distinct control-surface set for the demo. The fault-tolerance depth axis is untouched — four independently actuated canards still leave three after a single fault, the minimum for three-axis moment control, and the mixing-matrix reconfiguration story holds verbatim. Requirements re-pointed: REQ-SYS-005 (now actuated canards), new REQ-SYS-013 (static aft fins), REQ-CTL-002/003/004/005/006, REQ-FDR-001/007/009, and the REQ-SYS-010 / REQ-GCS-005 wording.
**Alternatives considered:**
- Actuated aft fins, no canards (original D030) — superseded; conflates stabilisation and control on one surface set.
- All-moving aft fins — rejected; same conflation, and larger actuated surfaces for no fault-tolerance gain.
- Both canards and aft fins actuated (eight servos) — rejected; doubles the actuator/servo cost and power draw without earning additional fault-tolerance story beyond 3-of-4.
**Cross-references:** D030 (superseded on actuated-surface choice; rationale retained), D027-family power topology (servo rail), `docs/cad/airframe-architecture.md` §7.

### D057 — Avionics bay as a detachable self-contained capsule; dedicated 5 V servo rail reaffirmed

**Decision:** The avionics is packaged as a **self-contained, detachable capsule** — its own subassembly carrying the MCU, both IMUs, the magnetometer, the barometer, the radio, batteries, power conditioning, and all mounting points — housed in the **forward (avionics) section** before the nose. The capsule is built and bench-tested standalone, then dropped into the section and secured by an internal fastening mechanism; the section carries **service panels** for in-place servicing without nose removal. Servo power and PWM are connected after the capsule is seated. The canard servos run on a **dedicated 5 V rail, separate from the MCU's 3.3 V rail** (the servo rail is Rail B per D033 / REQ-PWR-004; this entry reaffirms that the isolation now applies to the canard servos).
**Rationale:** A standalone capsule makes the avionics independently buildable, testable, and serviceable, and gives every component a defined mounting point — the right modularity boundary for a system whose avionics is the primary deliverable. The dedicated servo rail prevents servo-slew current transients (several amps across four servos) from browning out the MCU or injecting ADC-reference noise that FDIR would misread as sensor faults — a structural fix consistent with the existing power topology.
**Alternatives considered:**
- Avionics bolted directly to the airframe interior (no capsule) — rejected; poor serviceability, no standalone test path, couples avionics build to airframe build.
- Shared 3.3 V / 5 V rail for MCU and servos — rejected; brown-out and FDIR-false-positive risk (already rejected by D033's Rail A / Rail B split).
**Cross-references:** D025, D032 (Pi/MCU role boundaries), D033 / REQ-PWR-004 (Rail B servo rail), architecture §2.5 (power), `docs/cad/airframe-architecture.md` §6, §8. Open: capsule fastening, service-panel retention, nose mechanism, cable mating (airframe doc §12).

### D058 — Aluminium stringers removed; skin wall thinned 12 → 6 mm (revises D055)

**Decision:** The four CNC-aluminium stringers of D055 are **removed**. Joint bending and torsion are carried by the 8-bolt internal flange alone. The skin wall is thinned from 12 mm to **6 mm**, with the **150 mm bore preserved as a hard requirement** (reach-in access), so the **OD drops 174 → 162 mm**; the internal flange, insert bosses, servo brackets, and fin roots remain locally thick ("thin skin, thick features"). With the stringers gone the joint has no precise radial datum — radial centring is now loose (flange face + bolt clearance), seam steps are accepted and finished under primer/paint, and a **centring spigot/register is demoted to an exploratory TODO** (airframe doc §12.2) for the builder to explore before adopting. The first article is built as a **minimal stack** — avionics section / one empty section / aft-most section / cosmetic motor mount — to prove every hard interface (joint, capsule fit, canard mount, nose mating) on the fewest prints; additional empty sections are added later for length.
**Rationale:** The stringers were a flight-load instinct that bench loads (tens of N, ~tens of N·m) do not justify. The bolted flange reacts the worst bench moment with several-times margin before insert pull-out, and a 162 mm / 6 mm-wall tube is hugely over-stiff (section I ≈ 9×10⁶ mm⁴; ~0.4 mm tip deflection under 50 N at 0.9 m) — 12 mm of PLA at this diameter does not meaningfully bend, and the stringers' ~50% stiffness contribution sat on top of an already wild over-spec. Removing them and halving the wall cuts wall volume by well over half (mass, print time, filament — risk R-AF-03) and lightens the top-heavy CG, while deleting the stringer-bore coaxiality assembly risk entirely (R-AF-01 closed). The 12 mm wall was itself partly a consequence of embedding the Ø5 stringer bores; with the bores gone, denting/handling margin sets the wall, and 6 mm is a deliberately conservative ("still want to be safe") choice over the ~4 mm the stiffness math would allow.
**Alternatives considered:**
- Keep the stringers — rejected; unjustified mass/machining/assembly cost for bench loads, and the source of the coaxiality risk.
- Thin to ~3–4 mm — viable by the stiffness math but rejected for now in favour of a safer 6 mm; the new limiting mode is local denting, not bending, so margin there is cheap insurance.
- Keep OD 174 and open the bore to 162 — offered; rejected in favour of preserving the 150 mm bore (the stated hard access requirement) and taking the OD reduction.
- Add a centring spigot now — deferred to an exploratory TODO; it is the clean radial datum once stringers are gone (no longer over-constrained), but the builder wants to explore its geometry/assembly before committing.
**Cross-references:** revises D055 (stringer + wall-thickness portions; the joint clamp/flange/insert scheme stands); `docs/cad/airframe-architecture.md` §3–§5, §12.2; risk register R-AF-01 (closed), R-AF-03 (downgraded). The companion `aft-most-section.md` and `aft-most.step` predate this and carry the superseded OD/wall/stringer figures.

### D059 — Control surfaces have no aerodynamic authority on the static bench; demo is commanded-response

**Decision:** It is recorded as a scope clarification that the canards (and fins) exert **no aerodynamic moment on the static test stand** — there is no airflow. The demo is therefore **commanded-response, not closed physical control**: a manual perturbation of the stand produces an attitude error, the estimator senses it, and the canards throw in the correct restoring sense, with **demo mode deliberately exaggerating the deflection** (REQ-CTL-004) for visible "violent" effect. The verifiable behaviour is the correct *commanded* canard response (sign/magnitude vs. estimated error) plus the live estimator/health telemetry — not vehicle motion. `REQ-CTL-001` and `REQ-CTL-006` are reworded to govern the command-path response, with physical attitude restoration explicitly out of scope on the static bench.
**Rationale:** Honesty to the bench setup (Constraints §10 spirit): TVC is excluded and there is no flow, so aerodynamic surfaces cannot move the article. Writing CTL-001/006 as "attitude returns to setpoint" made a physically unrealisable claim and an unverifiable requirement. Reframing to the commanded response keeps both requirements verifiable, preserves the GNC story (estimator → control law → correct actuator command under fault), and matches what the audience actually sees. The exaggerated demo-mode throw is a feature, not a defect — it makes the (otherwise authority-free) reaction legible.
**Alternatives considered:**
- Add an airflow source (fan/tunnel) to give real authority — rejected; scope creep, and not needed for a GNC/FDIR demonstration whose depth axis is estimation and fault tolerance, not aerodynamics.
- Leave CTL-001/006 as written — rejected; an unverifiable, physically false requirement is a documentation defect.
**Cross-references:** D056 (canards as the software control-authority surfaces), REQ-CTL-001/003/004/006, `docs/cad/airframe-architecture.md` §7, §10.

---

## 2026-06-18

### D060 — Magnetometer threaded through the estimator/FDIR contract (amends D050)

**Decision:** Extend the D050-locked algorithm contract so the magnetometer (added as a type-only change in D054) can flow through the estimator and FDIR. Bounded, append-only additions — no removals, no restructure:
- `predicted_readings_t` gains `float mag_pred_ut[3]` — predicted Earth field in the body frame (reference field rotated by the predicted orientation), the gate's mag-residual source.
- `fdir_gate_result_t` gains `chi2_mag`, `mag_gate_open`, `mag_stale_us` — per-channel parity with the IMU fields.
- `estimator_update()` gains `const mag_reading_t *mag` (after `baro`); `estimator_predict()` is unchanged (it predicts the mag internally from a stored nav-frame reference field).
- `fdir_admit()` and `fdir_gate()` each gain `const mag_reading_t *mag` (after `baro`).
- Architecture §4 (struct lists, tick sequence, fault chain, interface contracts) and `main.c` call sites updated to match. The `.c` bodies remain stubs — real EKF/FDIR logic is Task 2 / Task 3.

**Rationale:** The estimator/FDIR signatures were locked under D050 (2026-06-14), *before* the magnetometer existed (D054, 2026-06-17), so the data path Task 2 ("magnetometer bounds yaw") and Task 3 ("chi-squared for IMU1, IMU2, and the mag") describe was absent — the reading could not reach the correction and the gate had no mag channel. This amendment is the single prerequisite gating Task 2 implementation; it follows the append-only amendment precedent of D053-A7. **Honest fault-detection framing (resolves the "single sensor, nothing to check against" concern):** the lone mag has no twin, so it gets NO direct cross-check like the dual-IMU gyro-vs-gyro pass. It is instead checkable two other ways — (1) the **innovation gate** vs the IMU-predicted field, an analytical cross-check against the attitude the gyro+accel maintain (this is what makes the constraints §5 magnetic-disturbance failure mode detectable with one sensor — voting needs redundancy, innovation gating needs only a model + complementary sensors); and (2) **absolute invariants** — `|B|` field-magnitude and dip-angle vs the known Earth field, needing no twin and (for `|B|`) no model. Covariance is meaningful with one mag: the mag update shrinks yaw covariance, isolation grows it on gyro drift — that growth-vs-shrink IS the "yaw bounded with mag, drifts without" demonstration. Accepted limit: with no twin, a slow sub-threshold disturbance or a wrong reference-field constant is not catchable; §5 targets gross "nearby metal," which the magnitude + innovation checks catch.
**Alternatives considered:**
- Estimator-only (mag corrects yaw, FDIR does not gate it) — rejected; makes the §5 magnetic-disturbance failure mode undemonstrable (a core Task 5 deliverable) and lets a bad mag reading silently corrupt yaw.
- Drop the mag from the algorithm path — rejected; reverses D054 and re-opens R-YAW-01 in substance (the mag becomes dead weight).
- Overload an existing struct/parameter instead of adding explicit fields — rejected; opaque, and a `-Wconversion`/review hazard.

### D061 — Dual-IMU estimator state: true fusion, 9-state error EKF with per-IMU gyro bias

**Decision:** When `estimator.c` is implemented (Task 2), the filter is an error-state EKF with nominal quaternion + **per-IMU gyro bias**: a **9-dimensional error covariance** `[δθ(3), δb_gyro1(3), δb_gyro2(3)]`. Record-only — it needs no contract or code change now (the state vector and 9×9 covariance are private to `estimator.c`; the exported `covariance[6]` and all public types are untouched). `predicted_readings_t` already carries per-IMU accel predictions, which fits this directly.

**Rationale:** A single shared 3-element gyro-bias state cannot separate the independent drift of two heterogeneous IMUs (BMI160 vs ICM-42688-P) — it estimates one blended effective bias, which is redundancy, not fusion. Per-IMU bias states make the fusion honest *and* feed the depth axis: the gyro difference `ω₁−ω₂` directly observes `b₁−b₂`, a built-in slow-drift disagreement detector that complements FDIR's gate (gross/fast) with a slow-relative-drift signal. Observability holds on a static bench: the differential bias is directly measured every tick, the common bias is observed through accel/mag attitude corrections during hand perturbations. Compute is comfortable — a 9-state sequential-update EKF (no matrix inversion) runs in ≪ 1 ms at 1 kHz on the M4F single-precision FPU. The accelerometers need no per-sensor state (each is a sequential measurement update); the drift concern is specifically gyro bias, since only the gyro integrates into unbounded attitude error.
**Alternatives considered:**
- 6-state shared gyro bias (redundancy / one-active-gyro model) — rejected as "fusion"; cannot represent two independent drifts. Defensible only if renamed redundancy with the second gyro as failover + cross-check.
- Plain averaging of the two gyros — rejected; ignores per-sensor noise and bias, and destroys the disagreement signal the dual config exists to expose. Not fusion in any meaningful sense.
- Per-IMU scale-factor + misalignment states (12–15 state) — rejected; those error modes are excited only by large sustained rates, which a static hand-perturbed bench does not see.

### D062 — Estimator design lock + contract finalization (builds on D061; amends D050/D060)

**Decision:** Lock the full `estimator.c` implementation design so the coding session is pure algorithm, and finalize two contract points it requires.

*Filter / math:*
- **Error-state (multiplicative) EKF**, 9-state error covariance `[δθ(3), δb_gyro1(3), δb_gyro2(3)]` over a nominal quaternion + per-IMU gyro bias (D061).
- **Propagation:** small-angle *linear* quaternion update + renormalize each tick (no `sin/cos` — at 1 kHz the per-step angle ≈ 0.001·ω rad); propagate on the **inverse-variance-blended bias-corrected rate**; covariance `P ← F·P·Fᵀ + Q`.
- **Corrections:** **sequential scalar updates** (each measurement component processed singly, diagonal `R`) → no matrix inversion anywhere; **Joseph-form** covariance update. Measurements: accel₁, accel₂ (bound roll/pitch), mag (bounds yaw), and the **differential-bias pseudo-measurement** `(ω₁−b̂₁)−(ω₂−b̂₂) ≈ 0`, Jacobian `H=[0|I|−I]`, noise `R_diff = R₁+R₂` — makes the per-IMU biases observable and feeds the differential-drift fault signal. The estimator reads *raw* gyro data (always did, as input), not FDIR's verdict → no D050 boundary violation.
- **Numerical hygiene (single-precision float — the FPU is single-precision; double would be soft-emulated):** renormalize the quaternion each step, symmetrize `P ← (P+Pᵀ)/2`, enforce a diagonal **PD-floor** (no variance silently reaches zero — TEST-EST-008), guard NaN/inf, ≥2 ASSERT/function.
- **Conventions:** Hamilton quaternion, NED nav frame (documented to kill sign bugs).
- **Init / reset:** attitude seeded from the first accel (roll/pitch) + mag (yaw); biases zero; `P` large-attitude / moderate-bias priors; `reset()` returns a deterministic known state for replay (TEST-EST-009/011).
- **Degraded modes:** an isolated IMU has its **bias state frozen** (its covariance does not grow unbounded); `DEAD_RECKONING` (both gyros gone) propagates on the **last blended bias-corrected rate** with covariance growing; mag isolated → no yaw update → yaw covariance grows.

*Resource / discipline:* Compute is **not** the binding constraint — a dense 9-state MEKF at 1 kHz is comfortably single-digit-% CPU on the M4F (to be confirmed on the Task-8 target build); the binding constraints are single-precision numerical health, memory footprint (P is 324 B; total < a few KB of 192 KB), and JPL auditability. Therefore: **simple + robust + auditable first; profile-then-optimize on target** (no premature sparse-block math). JPL Power of 10 throughout — fixed-size matrices, no malloc, bounded loops, no recursion; **purpose-built fixed-size** math primitives, not a general matrix library. All tuning constants (`R`, `Q`, initial `P`, `g_nav`, `B_nav` from an Abu-Dhabi geomagnetic model) ship as **provisionals with a prominent must-replace marker** next to the code (per LR-2 / geomag source) before the code is considered final.

*Contract finalization (the two code-facing tweaks, applied this session):*
1. **Baro removed from `estimator_update`** — altitude is unobservable in an attitude-only state, so the estimator does not fuse baro. Param dropped from the signature (and `main.c` call site); FDIR (`fdir_admit`/`fdir_gate`) still monitors baro health independently, and telemetry still carries it.
2. **`attitude_estimate_t.covariance[6] → [9]`** — exports the full 9-state error diagonal `[δθ×3, δb1×3, δb2×3]`, mapping the EKF cleanly and surfacing per-IMU bias + the differential-drift fault signal to the GCS. This changes the `telemetry_frame_t` wire layout → **`AVIONICS_PROTOCOL_VERSION` bumped 2 → 3**; the GCS parser (task 9) and telemetry serializer must match.

*Verification / coverage:* the `make coverage` reporter (clang `--coverage` → `llvm-cov`, a separate instrumented build) is pulled into Task 2 and built **after** the implementation; the ≥90%-branch G1 bar is met by a harness that drives every degraded-mode and numerical-guard branch (coverage measures, assertions verify).

**Rationale:** Recording the complete design up front lets the implementation session reserve full capacity for the code (per Sultan's working method — code lands section-by-section, ≤50 lines/commit, ≥5 explanatory paragraphs each). The MEKF + sequential-scalar + Joseph + small-angle stack is mutually reinforcing for JPL compliance and single-precision robustness, which is the actual risk surface here (not speed). Baro-out keeps the state minimal and honest; `covariance[9]` is the natural export of a 9-state filter and is free to change now while telemetry/control-law/GCS are still stubs.

**Alternatives considered:**
- 6-state shared gyro bias — rejected (D061): cannot separate two drifts.
- Vector measurement update with explicit `S⁻¹` — rejected; sequential scalar avoids all matrix inversion and is more numerically robust (requires only diagonal `R`, which holds for axis-independent accel/mag noise).
- Naive `(I−KH)P` covariance update — rejected; loses symmetry/PD in single precision. Joseph form is the robust choice and the cost is affordable given the compute headroom.
- Baro fused via a vertical channel — rejected; grows the state and the output contract for a quantity unobservable on a static, non-translating bench.
- Keep `covariance[6]` — rejected; cannot represent the 9-state diagonal; a partial export hides exactly the per-IMU bias health the depth axis wants visible.
- Build sparse-block covariance math up front — rejected; adds bug surface and hurts auditability for a speed gain we do not need.

---

## 2026-06-19

### D063 — FDIR implementation design-lock (two-tier severity) + telemetry-contract cleanup (amends D050 / D060 / D053)

**Decision:** Lock the `fdir.c` implementation (Task 3) and thread the FDIR gate output and reset cause onto the downlink.

*FDIR design:*
1. **Two-tier severity, mapped onto the two passes (D050).** `fdir_admit` runs the TIER-1 (hard) absolute checks — driver `status ≠ OK`, staleness, physical envelope / saturation, NaN/Inf, and the mag `|B|` magnitude — which isolate IMMEDIATELY and latch. `fdir_gate` runs the TIER-2 (soft) innovation checks — per-channel chi-squared and the mag dip-angle — which withhold the measurement for the tick but latch the channel only after `FDIR_DEGRADE_COUNT` consecutive failures. Per channel: `health = (NOT latched) AND (no TIER-1 fault now) AND (gate open now)`.
2. **Latch-until-reset (no auto-recovery).** Once isolated a channel stays isolated; the latch clears ONLY via `fdir_init()` — a reset/reboot is the sole operator re-admit path (no soft re-admit command exists; future work). NaN/Inf is the non-negotiable immediate isolate (it must never reach the estimator's `!isfinite` ASSERTs).
3. **Gyro cross-check = DETECTOR ONLY (A1, "innocent until proven guilty").** Two sensors cannot name the culprit, so an IMU1-vs-IMU2 gyro disagreement isolates neither IMU; it raises a soft operator caution (`gyro_disagree`) and leaves isolation to the innovation gate (when the fault also moves the accelerometer) and to the D061 differential-bias state (slow drift).
4. **β innovation-variance gate (amends D060).** D050 forbids FDIR importing the estimator and gives it no covariance to invert, so `estimator_predict` exports per-axis a-priori innovation variances `S_k = H_k P⁻ H_kᵀ + R` in `predicted_readings_t`, and the gate forms `chi2 = Σ_k (z_k − ẑ_k)² / S_k`. This is ADAPTIVE (S grows with P under degradation → the gate loosens instead of false-tripping) and inversion-free (stays on the single-precision FPU, D062). The rank-2 accel/mag Jacobian makes the radial/magnitude direction carry only `R` and the two tangential directions `P+R`, so the 2-DOF structure is implicit (`CHI2_THRESHOLD_2DOF`).
5. **Staleness reference.** `fdir_admit` is passed no clock and may not include a hardware header (layer rule), so "now" = the newest input timestamp this tick; a wholly dead bus is caught by its status field, not the timestamp arithmetic.
6. **Scope boundary.** `fdir_admit`/`fdir_gate` own only sensor health (imu1/2, baro, mag). `actuator_healthy[]`/`radio_healthy`/`wired_healthy` are written by the separate task-5 actuator-fault path, not these passes — FDIR remains the sole writer of `health_flags_t` overall (verified by the TEST-FDR-014 grep).

*Telemetry-contract cleanup (protocol v3 → v4):*
- `fdir_gate_result_t` gains `gyro_disagree`.
- `telemetry_frame_t` gains `fdir_gate_result_t gate` and `reset_cause_t reset_cause`: the live chi² / gate-open / staleness / gyro-disagree signals and the classified last-reboot cause (D053 A4/A6) are now downlinked unconditionally. `telemetry_pack_and_send` and the `main.c` call site are updated. `predicted_readings_t` also grew (the β fields) but is internal — not on the wire — so only the `telemetry_frame_t` change drives the **`AVIONICS_PROTOCOL_VERSION` bump 3 → 4**; the GCS parser (task 9) and the telemetry serializer must match.

*Provisional constants (all carry `*** MUST BE REPLACED ***`):* `CHI2_THRESHOLD_2DOF` = 13.8 (LR-3); the physical envelopes `FDIR_ACCEL_ABS_MAX` / `GYRO_ABS_MAX` / `PRESS_MIN/MAX` (datasheet / CAL); the baro & mag staleness windows (sensor rates); `FDIR_B_EXPECTED_UT` / `B_TOL_FRAC` / `DIP_COS_EXP` / `DIP_COS_TOL` (LR-2 geomagnetic model); `FDIR_GYRO_CROSS_MAX` (LR-3 / CAL); `FDIR_DEGRADE_COUNT` = 5 (CAL). The gate noise is the estimator's own `R` (LR-2), not a separate FDIR knob.

**Rationale:** The two tiers match the physics: a saturated/NaN/stale sample is *impossible*, so it earns no benefit of the doubt (immediate), while a finite-but-surprising innovation may be a transient bump, so it is debounced — spike-immunity without slowing the detection of a real hard fault. Latch-until-reset is conservative FDIR doctrine: a sensor that failed is not silently re-trusted without a human, and it eliminates health-flag flapping. The β export is the keystone — it lets FDIR run a statistically-grounded, covariance-aware gate while obeying D050 (one-way dependency, value-passing) and D062 (no matrix inversion); the adaptivity is the same "covariance is load-bearing" principle as §4.4 invariant 3, applied to detection. Surfacing `gate` + `reset_cause` is required by the depth axis (the operator must see *why* a channel was isolated and whether the board rebooted from a fault) and was the anticipated protocol bump.

**Alternatives considered:**
- Fixed per-channel gate variance `σ_gate²` instead of the exported `S` — rejected; non-adaptive (false-trips once covariance grows under degradation) and adds a third tuning knob the filter's `R` + the threshold already cover.
- Full 3×3 `S` NIS `rᵀS⁻¹r` (textbook χ²) — rejected; reintroduces the matrix inversion D062 deliberately removed and the single-precision hazard with it. The diagonal `Σ r²/S` is calibrated by LR-3 Monte-Carlo (TEST-FDR-015) instead.
- Auto-recovery (non-latched) — rejected; re-trusting a failed sensor without operator action, and it permits flapping.
- Both-isolate on gyro disagreement — rejected; loses both IMUs on a single fault and breaks graceful single-channel isolation.
- Leaky-bucket debounce (decrement on clean) — deferred; the consecutive-count is simpler, with the intermittent-fault (bad/good/bad) limitation documented in-code for a CAL revisit.

**Cross-references:** `avionics/src/algorithm/fdir.c`, `inc/algorithm/fdir.h`; `estimator.c` (`innov_var` export); `inc/avionics_types.h` (`gyro_disagree`, `predicted_readings_t` β fields, `telemetry_frame_t` `gate`+`reset_cause`, `CHI2_THRESHOLD_2DOF`, protocol v4); `output/telemetry.h/.c`, `orchestration/main.c`. Tests: `test/test_fdir.c` (FDR-001…016 incl. amended 004/008/009/011, BND-001/002, severity/latch, §5 mag-disturbance, restrict-only, gyro cross-check, NULL-safety, FDR-014 grep), `test/fdir_cov.c` + Makefile `coverage`. G1: `fdir.c` 100 % branch / line / function; `estimator.c` 99.36 % branch after the β export.
