SomeZeldaFan/RocketPi-5/hardware/cad/aft-most.step

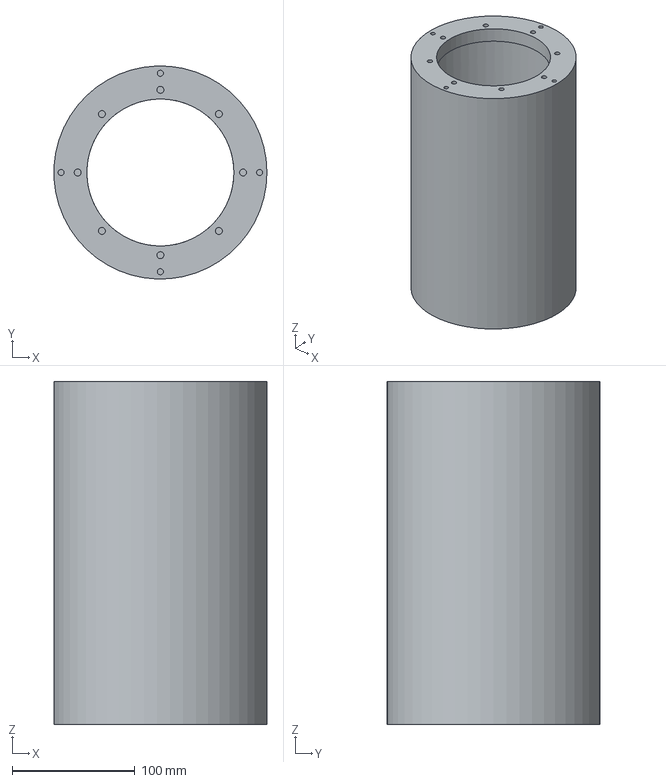
[picture p1: CAD file, 2026-06-16]
hardware/cad/aft-most.step
173.8 x 173.9 x 280.0 mm
