SomeZeldaFan/RocketPi-5/avionics/src/hardware/icm42688p.c

#include "hardware/icm42688p.h"
#include "hardware/platform.h"
#include "isr_flags.h"

/*
 * icm42688p.c — STUB
 *
 * Real implementation will:
 *   - Configure SPI2 with DMA streams for TX and RX.
 *   - Reset the ICM-42688-P, verify WHO_AM_I, configure ODR, FS range,
 *     AAF/UI filter, and the data-ready interrupt.
 *   - On data-ready, kick off a DMA register-read into a double buffer.
 *     SPI2 DMA TC ISR sets imu2_data_ready and swaps pages.
 *   - icm42688p_read() copies the latest filled page into *out, applies
 *     scaling, attaches platform_timer_us() timestamp, returns status.
 */

/*
 * Owning definition for the ISR/main-loop boundary flag declared in
 * isr_flags.h. The volatile qualifier comes from the volatile_flag_t typedef.
 */
volatile_flag_t imu2_data_ready;  /* zero-initialised by C startup; see isr_flags.h */

void icm42688p_init(void)
{
    /*
     * Real implementation: configure SPI2+DMA, init ICM-42688-P registers,
     * arm interrupts. Does NOT kick the watchdog (no per-_init() kicks, D053 A3).
     */

    /* PLACEHOLDER RETURN — NOT CONFIRMED SAFE.
     * This value has not been reviewed for correctness or safety.
     * Do not rely on this stub's output for any system behavior.
     * Safe default will be defined and justified during the
     * per-module scrutiny session for this file.
     */
}

imu_status_t icm42688p_read(imu_reading_t *out)
{
    /*
     * Real implementation: check imu2_data_ready; if set, atomically clear
     * it, scale raw counts to SI units, attach timestamp, return IMU_OK.
     * Otherwise return the appropriate failure status.
     */

    /* PLACEHOLDER RETURN — NOT CONFIRMED SAFE.
     * This value has not been reviewed for correctness or safety.
     * Do not rely on this stub's output for any system behavior.
     * Safe default will be defined and justified during the
     * per-module scrutiny session for this file.
     */
    (void)out;
    return IMU_TIMEOUT;
}
