SomeZeldaFan/RocketPi-5/(commit log)

2026-05-12 Reflect the decision to abide by JPL Power of 10 rules
2026-05-12 Lock constraints doc at v0.3 — public-facing reframe
2026-05-12 Update constraints to v0.4 — expand ground station UI scope, remove SD card logging
2026-05-12 Update constraints to v0.5 — reframe open questions, add NASA-STD-7009 candidate
2026-05-12 Log D020 — bidirectional telemetry link, demo/flight mode toggle
2026-05-12 Update constraints to v0.6 — C2 mode toggle in scope, true C2 as stretch
2026-05-12 Log D021 — retire time budget tracking (supersedes D002)
2026-05-12 Update constraints to v0.7 and current state — remove time constraints
2026-05-12 Bring current state up to date — Phase 0 complete, Phase 1 not started
2026-05-12 Open Phase 1, log D023 — architecture review precedes requirements
2026-05-15 Log D024–D034 — top-level architecture review locked; retire D011
    Captures the eleven structural decisions from the Phase 1 architecture
    review (per D023):
    D024 Dual heterogeneous IMU, separate buses
    D025 MCU-only real-time path; Pi never in the control loop
    D026 SPI for IMUs (each on own CS), I2C for barometer alone
    D027 Barometer included on MCU
    D028 Telemetry radio direct to MCU via UART+DMA
    D029 Both radio and wired MCU-Pi links, same protocol on both
    D030 Four independent fins, "+" configuration
    D031 Custom semi-monocoque airframe (retires D011)
    D032 Pi 5 role bounded to display, C2, logging
    D033 Split power rails, common ground
    D034 MCU hardware ti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
2026-05-15 Populate architecture doc — hardware and airframe sections
    Hardware architecture (§2) fully written; reflects D024-D034:
    sensor stack, compute roles, actuator stack, power, telemetry,
    time authority, interface summary, architectural boundaries.
    Airframe structural architecture (§3) added as a new top-level
    section with skeleton sub-sections to be populated as CAD work
    progresses (per D031).
    Software, ground station, and simulation sections remain skeleton
    with notes about what now constrains them. Formal block diagram
    deferred (methodology TBD).
2026-05-15 Add airframe risks, tests, and references (per D031)
    - Risk register: airframe-side seed risks (CAD iteration creep,
    print failures, fatigue, material selection, integration
    mismatch, undiagnosed coupling).
    - Test plan: structural test categories (material coupons,
    full-airframe load, demo-cycle fatigue, integration verification,
    power rail isolation, time authority).
    - Bibliography: aerospace structures references (Megson, Bruhn,
    NASA AM reports).
    No fibrous reinforcement or layup work — structural strategy is
    FDM-print-only (filament selection, wall thickness, infill, print
    orientation, printed-in features).
2026-05-15 Refresh current state — architecture review complete
    Phase 1 architecture review (per D023) complete. Phase 1 now opens
    two parallel tracks:
    - Avionics: write requirements rooted in the explicit system
    concept established in docs/05-architecture.md.
    - Airframe: begin CAD work — body geometry, avionics bay
    placement, fin pivot and gimbal mount integration (per D031).
    Pi 5 bring-up remains an independent parallel track.
2026-05-15 Remove camera references — not in scope and not physically present
2026-05-15 Update current state and open lab notebook — bring-up session 2026-05-16
2026-05-18 Populate requirements doc — first pass, sections 1–8
2026-05-18 Log D035–D036 — estimation algorithm and demo deliverable decisions
2026-05-18 Update current state — requirements first pass done, LR tasks open
2026-05-18 Update current state — hardware selection next, LR dependencies corrected
2026-05-18 Log D037 — hardware selection precedes LR-2 and LR-3
2026-05-19 Log D038–D042 — UAE regulatory confirmation and hardware selection
2026-05-19 Update current state — hardware selection complete, LR-2 and LR-3 unblocked
2026-05-19 Append lab notebook — hardware selection session 2026-05-19
2026-05-19 Clean up constraints — v0.9 editorial pass
2026-05-19 Update current state — constraints bumped to v0.9
2026-05-20 Add gitignore — exclude .DS_Store and datasheets/
2026-05-20 Log D043 — bare-metal superloop scheduling model
2026-05-20 Populate software architecture — §4 avionics firmware
2026-05-20 Add avionics coding framework — layered scaffold, type foundation, module stubs
2026-05-20 Update current state — coding framework scaffold complete
2026-05-21 Log D044 — airframe reinforcement boundary revised
2026-05-21 Update constraints v1.0 — §4 Phase 1 decisions resolved
2026-05-21 Log D045 — test protocol and gate structure
2026-05-21 Log D046 — actuator fault detection mechanism
2026-05-21 Log D047 — loop overrun policy
2026-05-21 Log D049 — FSM responds to sensing health only
2026-05-21 Update constraints v1.1 — add §10.7 validation principle
2026-05-21 Populate test plan — full enumeration with gate structure
2026-05-21 Update current state — test plan populated, D045–D049 logged
2026-05-21 Reword pre-implementation blockers — drop scheduled-date/owner phrasing
2026-05-21 Remove bench gimbal — demo is hand-held perturbation
2026-06-04 Remove HIL simulation scope — log D051, clean all docs
2026-06-05 Derive loop rate — LR-1 complete, AVIONICS_LOOP_RATE_HZ = 1000 Hz (D052)
2026-06-14 Resolve FDIR/estimator boundary — log D050, update architecture §4, log yaw risk
2026-06-14 Split FDIR into admit/gate and estimator into predict/correct — add predicted_readings_t (D050)
    [main.c]
2026-06-14 Update test plan for two-phase FDIR/estimator — TEST-EST-011 + FDR-007–010 (D050)
2026-06-16 Add aft-most CAD export and joint note
    [aft-most.step]
2026-06-17 Lock platform.h contract — log D048 (NVIC scheme) and D053 (watchdog architecture)
2026-06-17 Add macOS host build+test loop — algorithm layer compiles/runs on M3 (D053-A7)
2026-06-17 Ignore docs/cad-printing-reference/
2026-06-17 Select BMM150 magnetometer on dedicated I2C bus — close R-YAW-01 (D054)
2026-06-17 Lock airframe architecture — segmentation/joint, canards, avionics capsule (D055–D057)
2026-06-17 Remove airframe stringers, thin wall to 6 mm, reframe canards as visual-only (D058–D059)
2026-06-18 Thread magnetometer through estimator/FDIR contract — amend D050 (D060)
2026-06-18 Record dual-IMU true-fusion state design — 9-state per-IMU gyro bias (D061)
2026-06-18 Scaffold GCS Python package and tooling — mirrors MCU decomposition, pyserial venv (G1)
2026-06-19 Implement EKF attitude estimator + test suite — 9-state error-state filter, 99% branch cov (D062)
    [main.c]
2026-06-20 Audit and complete CAD docs: add CAD methodology, mag placement, power board
2026-06-20 Record selected M3 socket-cap screw in hardware schedule (B0FWQJT9NV)
